Naz712/fleet_adapter_template/3d_models/changi_es1_rescue_stairs/README.md

# Changi AES "ES1" rescue stairs – 3D print model

This folder has 3D-print models of the rescue stairs on Changi Airport Emergency Service's
Rosenbauer E8000-type stair truck. They cover the staircase only, without the vehicle, at three
platform heights. The models are 1:100 scale and come with a display stand, so each one stands
on its own.

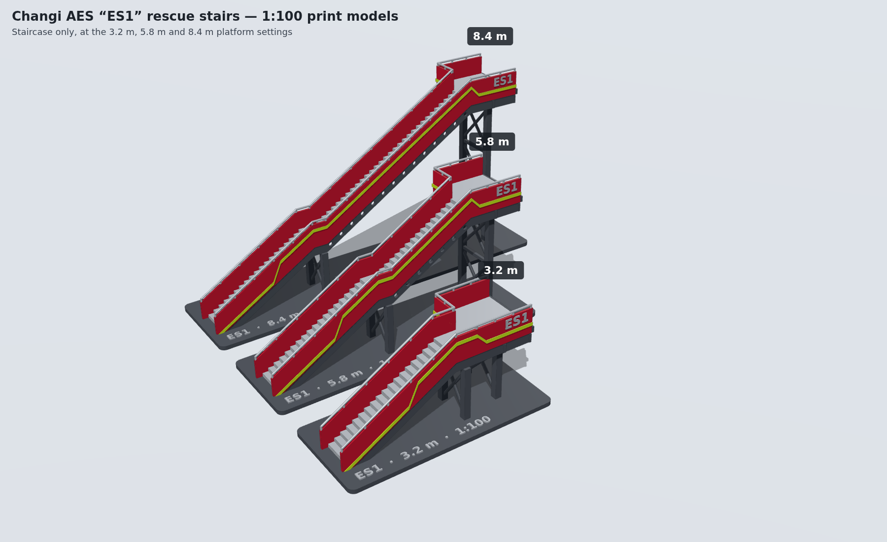
[picture p1: 3d_models/changi_es1_rescue_stairs/preview/lineup_3.2m_5.8m_8.4m.png]
Line-up


## Design

| Item | Value | Source |
|---|---|---|
| Stair width (clear, between side panels) | 1500 mm | brief (matches Rosenbauer spec) |
| Step height | 170 mm | brief |
| Bottom flight | 18 treads / 19 risers, landing at 3230 mm | brief |
| Mid platform length | 1000 mm | brief |
| Tread depth (going) | 280 mm, about 31° pitch | assumed from photos |
| Top platform | 2800 × 3000 mm, flush with the right-hand side and extending left | Rosenbauer E8000 data, photos |
| Guard panel / handrail | 900 mm / 1050 mm above the pitch line | assumed |

The steps stay close to 170 mm at every setting, so only the upper flight changes:

| Model | Top platform | Upper flight | Size at 1:100 (L × W × H) |
|---|---|---|---|
| 3.2 m | 3.23 m (19 × 170) | none: the mid platform runs straight onto the top platform | 98 × 45 × 45 mm |
| 5.8 m | 5.80 m | 15 risers × 171.3 mm | 138 × 45 × 71 mm |
| 8.4 m | 8.40 m | 30 risers × 172.3 mm | 180 × 45 × 97 mm |

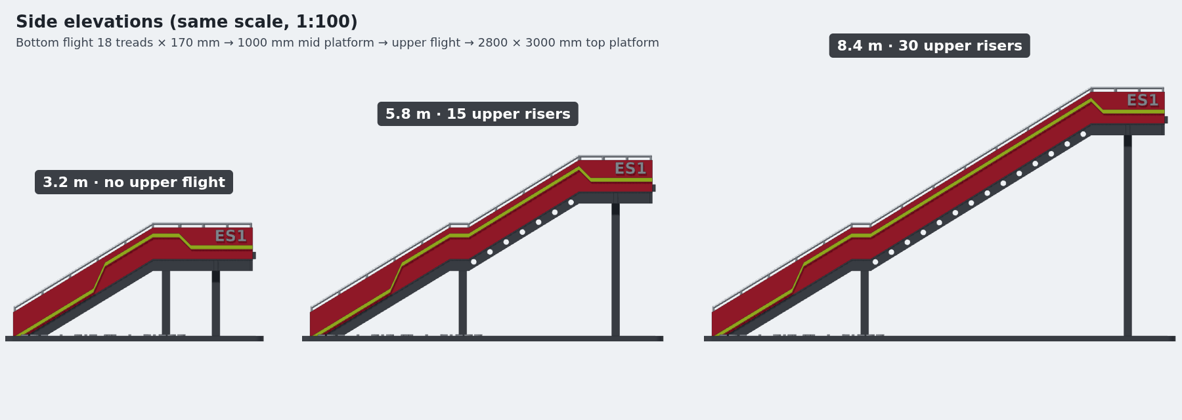
[picture p2: 3d_models/changi_es1_rescue_stairs/preview/side_elevations_same_scale.png]
Side elevations


## Files

- `stl/ES1_stairs_<h>_1-100.stl`: the main print. One solid body with the display stand and a
  name plate on the base.
- `stl/stair_only/…_stair_only.stl`: the staircase with no stand, for mounting on your own base
  or vehicle.
- `stl/multicolour/<model>/…_{red,silver,grey,lime}.stl`: the same model split into colour
  bodies for multi-material printers such as Bambu AMS or Prusa MMU. Load all four files at
  once as a single object with multiple parts, then assign a filament to each part.
- `stl/models.json`: step counts and dimensions for every file.
- `generate_stairs.py`: the parametric generator.

Every STL is checked to be watertight (manifold) and a single connected body.

## Printing tips

- **FDM:** print upright on the base with a 0.4 mm nozzle and 0.12–0.16 mm layers. Turn on tree
  supports and allow them to start on the model, not only on the build plate. The underside of
  the flights and the platforms needs support, but the treads, panels and towers don't.
- **Resin:** tilt the model about 30° and put supports on the underside.
- The livery (lime stripes and "ES1") is raised by 0.4 mm, so it also serves as a painting guide
  on a single-colour print.
- **Other scales:** scaling in the slicer is fine for going bigger. For example, 200% gives 1:50,
  but the 8.4 m model is then about 360 mm long. For a smaller scale, regenerate the files so the
  thin parts stay printable:

```bash
pip install manifold3d trimesh numpy matplotlib
python3 generate_stairs.py --scale 87 --heights 3200 5800 8400
```

Every design value, such as tread depth, platform size, livery or the label, is in the
`Design` dataclass at the top of the script.

## Two-track stair climber simulation

`track_sim/` checks whether a tracked casualty carrier can cross the ES1 stairs, including the
flat mid platform, when it is split into a front and a rear track unit joined by a driven
hinge. It carries a person in a reclining stretcher-chair on a driven levelling pivot, and
compares that vehicle with the same vehicle built as one long straight track.

Open `track_sim/index.html` in a browser, keeping `track-model.js` in the same folder. The page
animates the trip up or down at each height setting, plots the casualty's tilt and the hinge
bend, and recalculates everything when you change the seat or the vehicle, including layouts
with one or both halves of the tracks split in two. `track-model.js` also runs in Node:

```bash
node -e "const TM = require('./track_sim/track-model.js'); console.log(TM.simulate({ height: 8.4 }).summary.two)"
```

### Default design

- **Vehicle:** 0.70 m units (sprocket centre to sprocket centre), a 90 mm sprocket radius, and
  25 kg per unit. The hinge bends ±55° at up to 120° per metre of travel.
- **Seat:** a 120 kg person reclined 45° from vertical, in a stretcher-chair that weighs 25 kg
  with its drives. It sits on an arm 0.5 m above the hinge axle, so every posture from sitting up
  to lying flat fits. The seat's load centre is set 15 cm towards the head from the arm. The
  person rides head uphill: backwards going up and facing forward coming down.
- **Balance arm:** a drive at the foot of the arm leans it up to ±50° from halfway between the
  units, at 60° per metre of travel. It keeps the weight away from whichever edge the vehicle is
  near. Drives on top of the arm keep the seat level.

### Results

Worst case over the three height settings.

| | Two tracks + driven hinge | One long track |
|---|---|---|
| Casualty tilt, worst moment | 5° (the seat drives catch up within 3 cm) | 25° |
| Vehicle pitch change per 10 cm of travel | 7.9° up, 8.6° down | 31.6° |
| Worst drop at a platform edge | none, up or down | 23 cm (tips over the edge) |
| Lean it can take anywhere before it falls | 10.7° up, 8.3° down | falls at every edge |
| Hinge bend used | ±40° | – |

"Lean it can take" is how far a push, a hard stop or a bump can lean the weight before the
vehicle falls over an edge. A stop from walking pace (0.25 m/s) in 0.2 s leans it 7.3°.

The fit of the seat and person depends on the recline. With the default 0.5 m arm, the closest
gaps to the steps and to the vehicle's own tracks are:

| Recline | Posture | To the steps | To its own tracks |
|---|---|---|---|
| 15° | sitting up | 25 cm | 6 cm |
| 30° | leaning back | 34 cm | 15 cm |
| 45° | half lying, half sitting | 45 cm | 25 cm |
| 60° | half lying | 45 cm | 28 cm |
| 75° | mostly lying | 26 cm | 21 cm |
| 90° | lying flat | 11 cm | 2 cm (tight) |

### How the seat is held up

A level stretcher over a 31.6° flight has stairs about 0.6 m higher under one end of each metre
than the other, and the slope reverses at every platform. Legs on each track unit would have to
grow and shrink by that much all the time, so the support sits in the middle, on the hinge axle.
Operating tables hold lying patients the same way, on one central column with a tilting top.
The support is built to look and be sturdy:

1. **Two track units**, front and rear, each with a left and a right rubber track, 0.75 m across.
   The tracks have cleats that hook the step nosings.
2. **Hinge axle and hinge motor.** A 40 mm steel axle joins the units. A self-locking gear motor
   bends the hinge and holds a fold with the power off, about 580 N·m (1.2 kN·m with bumps). It
   must turn at least 90° per metre of travel (23°/s at walking pace).
3. **Averaging link.** A 150 mm arm fixed to each unit, and two equal links to a collar on a short
   post. The four equal sides make a diamond, so that post always points halfway between the two
   units. The arm leans from it, and it passes the arm's load equally into both units.
4. **Arm drive.** A self-locking gear motor at the foot of the arm leans it up to ±50° from halfway
   at 15°/s. It holds up to 500 N·m (1 kN·m with bumps).
5. **Arm.** Two 50 × 50 × 4 mm steel box columns 0.4 m apart, joined by cross tubes, 0.5 m from
   the hinge axle to the seat's tilt axle. The two columns stop it rocking sideways.
6. **Tilt drives and cradle.** Two self-locking tilt drives on top of the columns keep the seat
   level; either one can hold the seat alone. A cradle of two 40 × 40 × 3 mm rails and struts
   holds the seat on a triangle, not on a single point.
7. **Stretcher-chair.** Reclines from 15° (sitting up) to 90° (flat), with a four-point harness
   and a foot stop so the person can't slide more than about 10 cm.

Side to side, the centre of mass is 0.71 m off the ground, so a 0.75 m wide vehicle only tips
past 28° of side tilt. The stairs have no side slope, so that margin covers the person shifting
and bumps.

### Stress test

`stress-test.js` puts the default design through harder conditions at all three height settings,
in both directions, and sizes the support parts at twice the worst load:

```bash
cd track_sim && node stress-test.js
```

It also writes `stress-results.js`, which the page shows. A case passes if the vehicle never
falls and can take a 7.3° lean anywhere. It runs four ways of holding up the seat, and the three
layouts with one or both halves of the tracks split in two (see below):

| Seat support | Pass | Tight | Fail | Lean it can take, default (up · down) | Seat drives, with bumps |
|---|---|---|---|---|---|
| One balancing arm (recommended) | 17 | 4 | 3 | 10.7° · 8.3° | arm drive 1.0 kN·m, two tilt drives 0.48 kN·m |
| Two arms from the hinge (a V) | 12 | 6 | 3 | 9.5° · 7.8° | two arm drives 0.82 kN·m |
| Two arms, one on each track | 7 | 7 | 7 | 16.1° · 9.9° | two arm drives 0.89 kN·m |
| One arm without a drive | 7 | 9 | 5 | 8.0° · 8.2° | two tilt drives 0.48 kN·m |

One case is not a stress but a possible fix: a hinge motor half as fast again (180°/m). With the
balancing arm it passes, taking 13.1° up and 7.8° down.

Two arms holding the stretcher like a bed look the most reassuring, but only if they rise from
the hinge. Standing on the track units, the arms' feet swing at every fold and, on the flights,
one sits about 25 cm lower than the other. The arms have to keep correcting: on steeper stairs
the cradle tilts up to 16°, lying flat hits the steps, and the vehicle needs a faster, wider
hinge. Rising from the hinge, the two arms keep most of the single arm's stability. They lose
margin only with a 200 kg person, a person who has slid 25 cm, or a smaller hinge.

The single balancing arm passes the most cases. Its results case by case:

- **Passes:**
  - a 200 kg or a 40 kg person;
  - a person sliding 10 cm either way, or 25 cm towards the feet;
  - sitting up, or lying flat and sliding;
  - stairs as steep as 35.8°;
  - a hinge at three-quarter speed or with only ±45° of range, or one half as fast again;
  - a seat drive at half speed;
  - an arm drive that seizes in the middle or leaning uphill;
  - a seat drive stuck level, with the arm taking over the levelling.
- **Tight:**
  - lying flat comes within 2 cm of the front track;
  - an arm drive seized leaning 20° downhill;
  - a seat drive stuck on a flight;
  - a 200 kg person half lying on 35.8° stairs.

  None of these falls, but a hard stop at the worst moment could rock the vehicle.
- **Fails:**
  - a hinge motor at half speed drops 17 cm at an edge;
  - a hinge motor that seizes and keeps driving becomes one long track and drops 23 cm;
  - a 200 kg person lying flat on 35.8° stairs hits the tracks.

Without its drive, the arm only passes the default case with 8.0°. It fails with the person
sliding 25 cm, and is tight on steeper stairs and with a ±45° hinge. That is why the balance arm
is part of the design.

The support parts stay 6 to 100 times below their limit at twice the worst load for a 120 kg
person, and at least 3.7 times below for 200 kg. What the stress test asks for:

1. Keep the balance arm.
2. Use a hinge motor that turns at least 90° per metre of travel.
3. Stop the tracks the moment the hinge stops following.
4. After any drive fault, stop gently over half a second. That leans the weight only 2.9°,
   which every tight case can take.
5. Fit a four-point harness and a foot stop.
6. Make the arm about 5 cm taller if people will be carried lying flat on steeper stairs.
7. Use cleated tracks. Holding on the flight needs a grip (friction coefficient) of 0.61, and a
   hard stop going down 0.76. Wet rubber on steel can be well below that.

### Splitting the halves in two

The model also handles more than two sections (`sections` and `mainJoint` in `track-model.js`,
and "Track layout" on the page). The seat stays on the middle hinge. One or both halves are split
into two 0.35 m sections, joined by a hinge with its own motor, about 6 kg. The rules are the same
as for two sections, section by section. With two 0.70 m sections, the model gives exactly the same poses
as the two-section one, which is how it was checked.

Each extra hinge bends at an edge to keep its half's tracks on the stairs. While its half goes
last (going down for the front half, going up for the rear half), its end section stays flat on
the step behind while the section next to the seat follows the new slope. The trailing end keeps
holding the vehicle up just when a straight unit would lift off and leave it balancing on the
edge; most of the gain comes from this. While its half goes first, the half is held in line, but
once the extra hinge is past an edge it lets the end section down onto the next step, so the
tracks touch the stairs while the seat's hinge is still folding the half down. A short section
has to turn twice as fast for the same change of slope, so the extra hinge turns at up to 240° per
metre, twice the seat's hinge.

Worst case over the three height settings, with the balancing arm:

| | No split | Front half split | Rear half split | Both halves split |
|---|---|---|---|---|
| Lean it can take (up · down) | 10.7° · 8.3° | 11.2° · 18.7° | 17.9° · 9.5° | 18.8° · 21.5° |
| Stress test (pass · tight · fail) | 17 · 4 · 3 of 24 | 20 · 3 · 3 of 26 | 22 · 0 · 4 of 26 | 23 · 1 · 2 of 26 |
| Extra hinge motors, mass with the casualty | 0, 195 kg | 1, 201 kg | 1, 201 kg | 2, 207 kg |
| Extra hinge at 120°/m (up · down) | – | 11.2° · 9.3° | 13.3° · 9.4° | 13.7° · 12.3° |
| Extra hinges seized straight (up · down) | – | 10.3° · 7.7° | 10.0° · 10.0° | 9.9° · 8.8° |

- Splitting both halves is best both ways: 18.8° up and 21.5° down, and 23 of 26 stress cases.
  It is the only layout that still passes with the seat's hinge motor at half speed, because the
  leading half's end section reaches the stairs while the seat's hinge is still folding. If the
  seat's hinge seizes, it drops 12 cm, against 18 to 23 cm for the other layouts.
- The front split more than doubles the lean the vehicle can take going down, which is where no
  split is weakest. Going up it takes 0.5° more than no split.
- The rear split gains going up. Going down it gains only 1.2°, because its front half, which
  goes last going down, is not split. Lying flat, its backrest comes 4 mm into the front track
  unit, which fails that case.
- The failures left: the seat's hinge seizing (a 12 to 21 cm drop), and a 200 kg person lying flat
  on 35.8° stairs, whose backrest hits the steps. The front and rear splits also still fail with
  the seat's hinge motor at half speed.
- If the extra hinges seize straight, the vehicle becomes the one with no split, which passes.
- A 0.35 m section spans only one gap between nosings, so on a flight its hinge must hold it in
  line.
- How the leading half bends matters. Letting its end section down about its own hinge, lifting
  nothing, is what gains; folding the end section first by lifting the section inside it lifts
  that section off the edge nosing, and both halves split then takes only 11.9° going down.

`track_sim/compare.html` runs all four layouts side by side on the same stairs, plots the lean
each can take along the trip, and puts every stress case next to each other.
`node track_sim/compare-test.js` regenerates its per-height numbers (`compare-results.js`).

### Building a model

`track_sim/blueprint.html` is a build sheet for a model of the layout with both halves split,
made from parts sold in Singapore. Pick the GT2 pulley and closed belt loop you buy, and it redraws
the side view, the top view, the centre box space, the tread, the seat's hinge and the wiring to
scale, and sizes the test stairs to match. 20-tooth pulleys with 110 mm loops, both stocked in Singapore, put the axles 35 mm apart,
which is exactly 1:10. Its parts list (`blueprint-parts.js`) links each part to a shop. It also runs
the simulator on the test stairs (the `lowerTreads` option in `track-model.js` gives one flight) and
lists the hinge, arm and seat angles every 5 mm of travel, to replay from the drive motor's encoder.

### Bending test: no bending, 2 parts, 4 parts

`track_sim/bending.html` carries the casualty up and down the ES1 stairs as measured (8.4 m in two
flights of 175 × 250 mm steps, 35°, a 1 m mid-landing, a 3 m top platform) four ways, in step:
one stiff track, two track units, four sections, and a stiff track with front arms. It uses the team's levelling design: no seat
arm, the 3-part platform hinged on top of the centre box (`mastMode: 'base'`, 0.32 m above the
track axles) and kept level by a linear actuator. The box (400 × 400 × 220 mm, 15 kg) is bolted to
the section behind the middle hinge, and every pose checks its gap to the steps and to the platform.
The tracks are modelled on parts MISUMI stocks in Singapore: HTD 8M timing belts, 40 mm wide, on
60-tooth pulleys (85 mm from axle to grip, 15 mm cleats every 56 mm). 1200 mm belts give 0.36 m
sections and 1880 mm belts the 0.70 m units; the prototype uses HTD 5M belts on 20-tooth pulleys.

A hinge only pushes its track down onto the stairs (`reach: 'lie'`): to put a track end down it may
lift the vehicle off them by 5 cm at most (`maxLift`). It never stands the vehicle on its two ends
with the middle in the air. That would need a hinge motor strong enough to hold the vehicle and
casualty off the ground, with only the end tracks gripping. (The model's default, `reach: 'lift'`,
still allows it, for the older pages.)

It compares two ways of bending. **Stop, bend, then go** (`bendMode: 'stopGo'`, the page's
default): the vehicle drives at 0.25 m/s and stops wherever a hinge or the levelling has to turn
further than it can on the move (the middle hinge 30° a second, the end hinges 58°, the levelling
37.5°). A hinge only turns as far as still leaves 25° of lean before tipping (`stopGoSafeDeg`);
otherwise it holds its bend until more track is on the stairs. A laser at the leading end of the
track looks straight down (`laserRisers`): near a platform edge the hinges stay locked until it
reads 1¼ risers (219 mm) further than on flat ground, then the vehicle stops and bends. **Bend while
moving** (`bendMode: 'moving'`): the hinges turn as it drives, the middle one up to 120° per metre.

The front arms follow the Cal Poly Pomona "Wheelchair Stair Climber" on GrabCAD (`stair-climber-1`,
a 605 × 420 mm prototype): a stiff main track with a pair of track arms on its front axle that swing
up to climb a step and down to reach over an edge. Scaled up, a 0.80 m main track carries the box and
platform at its middle and 0.72 m arms swing down by up to 90° or up by up to 45°, where the platform
gets in the way (`reach: 'touch'`, `armUpDeg`). The main track rests on the stairs by its own weight
and the arms swing until they just touch the stairs ahead, so they catch the vehicle at an edge but
never hold it up. It turns round at the top so the arms lead both ways (`dirs` runs each way as its
own layout). The split matters: with the prototype's proportions (0.92 m and 0.60 m) it keeps only
7–10° at the top edge, while any main track from 0.66 to 0.83 m (arms making up 1.52 m) keeps about
25° going down and 11–15° going up.

| Layout | Least lean before tipping, down · up: stop, bend, then go | Bending while moving | Trip down · up, stop, bend, then go (of it stopped) |
|---|---|---|---|
| No bending (1.40 m) | tips · tips (drops up to 33 cm) | the same | 74 s · 74 s |
| 2 parts (2 × 0.70 m) | 14.5° · 17.5° | tips (drops up to 29 cm) | 79 s (5 s) · 79 s (5 s) |
| 4 parts (4 × 0.36 m) | 24.4° · 24.4° | tips (drops up to 8 cm) | 89 s (15 s) · 83 s (10 s) |
| Front arms (0.80 m + 0.72 m arms) | 25.9° · 14.0° | 8.7° · 8.0° | 80 s (6 s) · 81 s (8 s) |

Stopping to bend is what keeps the hinged tracks up: bending while moving, the hinges can't fold a
track end down in time at an edge without lifting the vehicle. The front arms are the exception:
they only have to touch the stairs, so they stay up bending while moving too. The 4-part track keeps the most lean.
The 2-part track stays up, but its long halves overhang an edge until the middle hinge gets there.
The track that can't bend tips at the edges either way: it has no hinge to bend. The casualty stays
within 1° of level on the bending tracks.

Where the laser stops it matters. On the flights the steps alone make it read up to 1.1 risers
further than on flat ground, so it must stop above that; any later and more of the track is past
the edge before it bends:

| Laser stops it at | 2 parts, down · up | 4 parts, down · up | Front arms, down · up | |
|---|---|---|---|---|
| 1 riser (175 mm) | 15° · 18° | 24° · 24° | 26° · 14° | would also stop on every step of the flights |
| 1¼ risers (219 mm) | 15° · 18° | 24° · 24° | 26° · 14° | best: the same as stopping in exactly the right spot |
| 1½ risers (263 mm) | 11° · 18° | 10° · 24° | 19° · 14° | late going down at the mid-landing |
| 2 risers (350 mm) | 11° · 18° | 10° · 22° | 19° · 14° | late at the mid-landing; the 4-part platform brushes its tracks |
| 3 risers (525 mm) | 11° · tips | 10° · tips | 19° · 14° | 2 and 4 parts tip going up at the mid-landing edge and the top edge (drops up to 26 cm), and going down their platforms knock their own tracks |

The 2-part units are 0.70 m from axle to axle. Stopping to bend, that is as steady as 0.76 m
(15° going down, 18° going up), 12 cm shorter overall (1.57 m), and it takes a stock 1880 mm HTD 8M
belt (235 teeth). At 0.69 m one end rocks down 5 cm at an edge going down, leaving 8.5°, and its belt
would need 232½ teeth. Bending while moving, every length tips at an edge. At 1:5 the units are
140 mm on 380 mm HTD 5M belts (76 teeth). The page also lists the tallest box
for each length, the stricter of the two ways of bending (4 parts: 300 mm long at 250 mm tall, or
400 mm at 244 mm; 2 parts: 500 mm at 250 mm; front arms: 400 mm at 250 mm; no bending: 600 mm at
250 mm). The 400 × 400 × 220 mm box fits all four.

### How the 2-part vehicle is built

The page's "How it is built" section draws the 2-part vehicle with 0.70 m units at full size: a top
view with the platform removed, and a side view of the hinge. Its "Track parts and dimensions"
section lists the sizes, full size and 1:5.

- **Two units on one axle.** The rear and front units both turn on the middle axle, on bearings in
  their side plates: the rear unit's plates inside, the front unit's just outside them. Each unit has
  one 40 mm belt per side. The rear unit's belts run in the outer lane and the front unit's in the
  inner lane, so both fit on the middle axle. Overall 1570 × 700 mm (1600 mm over the cleats),
  170 mm tall (200 mm with cleats), 400 mm between the side plates.
- **Hinge.** A worm gear motor in the box turns a cross shaft with a small gear at each end. Each
  gear meshes with a toothed sector on one of the front unit's side plates, so the two units swing
  up to 55° either way about the middle axle, at 30° a second. These stairs need 35° up at the foot
  of a flight and 39° down over an edge. The bend is the angle between the units, so either one can
  tip: going down, the rear unit leads and tips over the edge, carrying the box. A worm resists being
  back-driven, but vibration can make it creep, so the motor also has a spring-applied brake to
  hold the bend with the power off. At 1:5 the gears are bigger than scale (module 1.25, 32 : 14
  teeth, about 2.3:1), so they can be printed and a 270° servo covers the whole ±55°.
- **Drive.** The drive motor in the box turns the middle axle through a chain. Both units' pulleys are
  clamped to it, and bending about it doesn't stretch or slacken the belts, so both tracks drive at
  any bend. The end axles turn freely.
- **Box and platform.** The 400 × 400 × 220 mm box holds the battery, the drive motor and the hinge
  motor. It sits between the rear unit's side plates, from 280 mm behind to 120 mm in front of the
  middle axle. The platform pivots on two pillow blocks on top of it, 320 mm above the middle axle.
  The platform and its levelling are designed separately.
- **Lasers.** One at each end, 45 mm beyond the end axle, looking straight down between the tracks.
- **Axles.** 35 mm steel bar (C45) at full size in UCFL207 flange bearings; 8 mm rod in KFL08s at
  1:5. The worst case is a step edge under the end of a unit while the belts pull hard: about 1.7 kN
  on each pulley. The rear unit's belts run in the outer lane, 108 mm outside its bearings, so they
  bend its axles with about 180 N·m, and the middle axle also carries up to about 65 N·m of drive
  torque each side and the chain's pull. A 35 mm axle takes that with a safety factor of about 3 and
  bends so little that the outer pulleys tilt under 0.25°, the limit for timing belts. A 30 mm axle
  would tilt them 0.34°, and the belts would walk off; 40 mm only adds about 8 kg with its bigger
  bearings. At 1:5 the 8 mm rod is about four times stronger than it needs to be.
- **Slide strips.** A low-friction plastic strip under each belt's lower run, between its pulleys,
  carries the load where a step edge presses on the belt. Without it the belt bows up between the
  pulleys, by several centimetres at full size, and the tracks don't stay straight on the stairs as
  the simulation assumes.

The page also lists the parts for the tracks and hinge of one vehicle, with rough prices in Singapore
dollars (October 2026): about S$240 for the 1:5 prototype and about S$2,900 at full size. The motors,
battery, lasers and controller, and the platform with its levelling, come from the rest of the team.
RS Singapore prices are as listed; the rest come from online listings, and the full-size gears and
plates are estimates. Check stock and prices before ordering.

A second top view draws the 4-part version for comparison: four 360 mm sections on five axles, with
the same box, platform and lasers. Its middle hinge works as above; each end hinge has its own motor
on the end section, turning a toothed sector on the next section. It needs 8 shorter belts (1200 mm),
16 pulleys, 5 axles, 16 bearings, 8 slide strips and three sets of hinge gears: about S$460 at 1:5
and S$5,700 at full size.

### Printable track for the 1:5 prototype

`track_print/` has a 3D-print file for the prototype's tracks, sized to the team's 1:5 base:
two segments 225 mm axle to axle, each with a 550 mm track loop on wheels about 1.5 cm in
radius. The track is a one-piece TPU loop printed as a ring, with 110 HTD 5M teeth inside so it
runs on bought HTD 5M 20-tooth pulleys. Its 45 cleats are 12.22 mm apart, a fifth of the 1:5 ES1
edge-to-edge distance (35 × 50 mm steps, 61.03 mm along the slope), so every step edge under a
segment sits in a gap between cleats and the cleat above it stands on the tread. In the
simulator, 1.125 m segments (22.5 cm at 1:5) stop, bend and go as well as 0.70 m ones: 14.5° of
lean before tipping going down and 18° going up. See `track_print/README.md` for printing,
buying and assembly.

### Centre box, tracks and tread

The battery and drive motor go in a box between the tracks, bolted to the section just behind the
seat's hinge (T2). Bolting it to one section needs no extra linkage, and it is nearly as big as a box
held halfway between the two middle sections (93% of the side area). The space was found by
running every pose of the four-section chain (3.2, 5.8 and 8.4 m flights and the steepest stairs,
both ways) in that section's frame. Blueprint sheet C draws it.

| Centre box | Full size | 1:10 model |
|---|---|---|
| Length | 500 mm: 290 behind the seat's hinge axle, 210 in front | 50 mm: 29 behind, 21 in front |
| Height | 250 mm: floor 40 and top 290 above the axle | 25 mm: floor 4, top 29 |
| Width | up to 300 mm, inside the seat arm's two columns | 38 mm, between T2's side plates |
| Limits | the next section's axle (70 mm clear), the stairs below, the seat above | the same, 7 mm clear |

Only the hinge axle passes under the box; a gear on it reaches up through a slot to the motor. At
1:10 the seat's hinge servo (S2) and the arm servo (S4) also sit in it, with the motor and a small
battery. Weight in the box steadies the vehicle a little: with 40 kg the worst lean it can take is
19.8° going up and 21.7° going down (18.8° and 21.5° without). `boxMass` in `track-model.js` tries
other weights.

Each section's track is a loop around two axles 350 mm apart (35 mm at 1:10), 150 mm wide per side
in two lanes, and 180 mm high (Ø180 sprockets). Neighbouring sections run in alternate lanes so
they share an axle. Pulleys are clamped to the axles and the section frames turn on bearings: the
motor turns the seat's hinge axle, which drives the middle two sections, which turn the next axles
and the end sections. One motor drives every track at the same speed. A full-size vehicle that
steers splits each axle into left and right halves, with one motor per side.

The tread is soft rubber (about 60 Shore A) with straight cleats across it: 15 mm tall, 20 mm wide
at the root and 10 mm at the tip, every 60 mm, offset by half a pitch between the two lanes. On
stairs the tracks only touch the step edges. A cleat just behind an edge drops onto the tread
within 1.9 times its height of the edge and catches there, so the tracks can't slide down even on
dusty or wet steps. Without cleats the rubber needs a friction of at least 0.62 to hold on these
stairs. Taller or sharper cleats jolt over each edge and wear the nosings.

### Design rules from the math

1. Each unit must always bridge two step nosings. Nosings are 328 mm apart, so a unit needs at
   least 657 mm.
2. One unit (0.88 m overall) must fit on the 1.0 m mid platform. The whole vehicle is longer than
   the platform, so it crosses in an S-bend.
3. The hinge needs a range of at least ±45°, even though the slope only changes by 31.6°. It has
   to fold the leading unit down before the middle reaches the edge.
4. The hinge must be driven, at 90–150° per metre of travel. Slower, the fold comes too late and
   the vehicle drops at an edge. Much faster, it over-reacts. With a free hinge, the units follow
   gravity and the front rears up on the risers.
5. The hinge holds its fold over an edge until the centre of mass is 5 cm past it, so the trailing
   unit keeps its end on the stairs.
6. The vehicle must be able to take a hard stop anywhere, a 7.3° lean. The balance arm and the
   seat's offset towards the head give it at least 8.3°.
7. Half lying (a 45–60° recline) is the most compact posture. Sitting up and lying flat both need
   the 0.5 m arm.
8. A split half's hinge bends at each edge to keep the tracks on the stairs, at twice the seat
   hinge's speed. Going last, it keeps the end section on the step behind. Going first, it holds
   the half in line but lets the end section down onto the next step once it is past the edge.

The model is quasi-static (slow speed). At every centimetre it solves how both units rest on the
real step geometry, then checks support, the gap around the seat and person, and tipping. Tracks
ride on the line joining the step nosings. The person is a 1.80 m adult built from standard
body-segment proportions. Forces and torques are for slow, steady driving, with a factor of two
for bumps; impacts and braking dynamics are not modelled.
