Naz712/fleet_adapter_template/3d_models/changi_es1_rescue_stairs/preview/ES1_stairs_5.8m.png

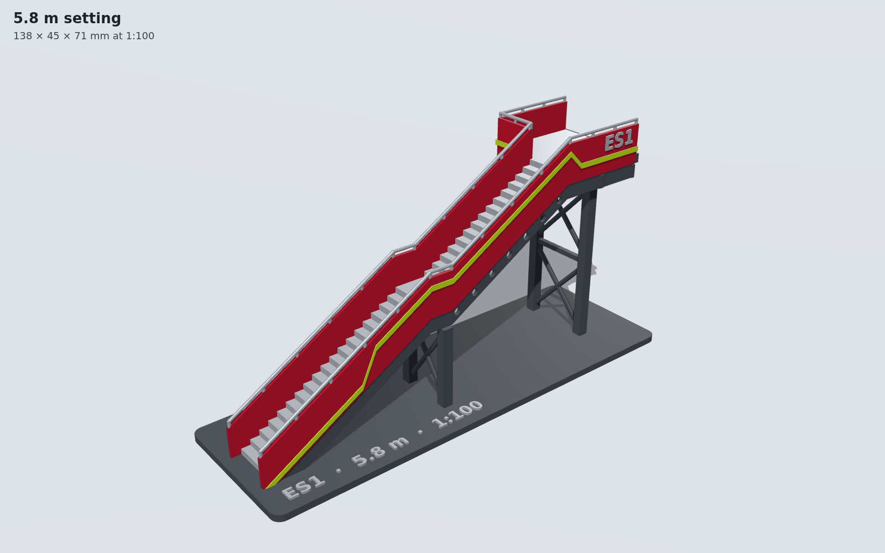
3d_models/changi_es1_rescue_stairs/preview/ES1_stairs_5.8m.png
