Naz712/fleet_adapter_template/3d_models/changi_es1_rescue_stairs/preview/ES1_stairs_8.4m_top_platform.png

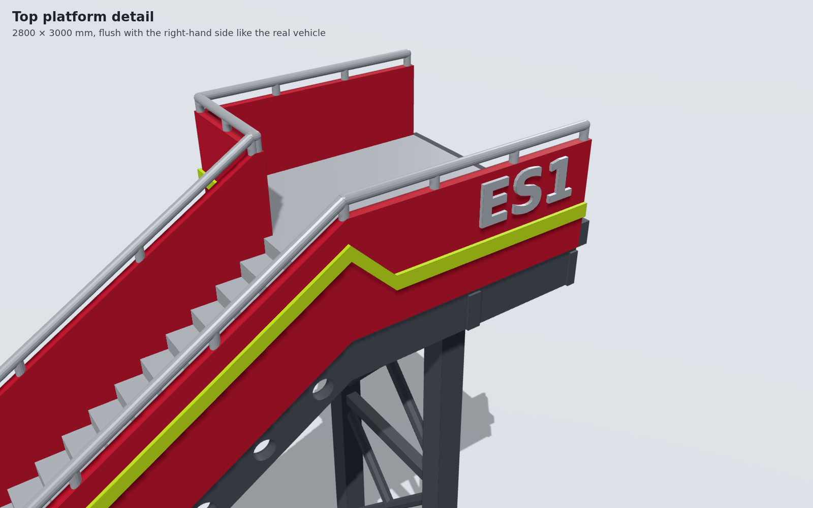
3d_models/changi_es1_rescue_stairs/preview/ES1_stairs_8.4m_top_platform.png
