Naz712/fleet_adapter_template/3d_models/changi_es1_rescue_stairs/slides/slide3-top-view.png

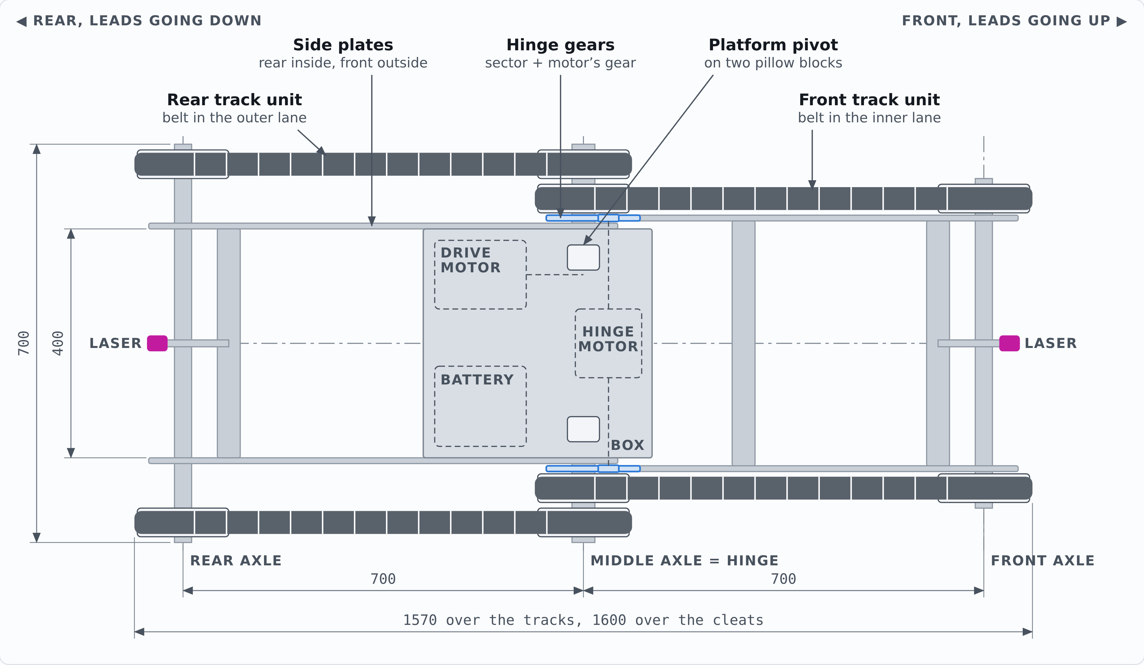
3d_models/changi_es1_rescue_stairs/slides/slide3-top-view.png
