Naz712/fleet_adapter_template/3d_models/changi_es1_rescue_stairs/slides/slide5-stop-bend-go.png

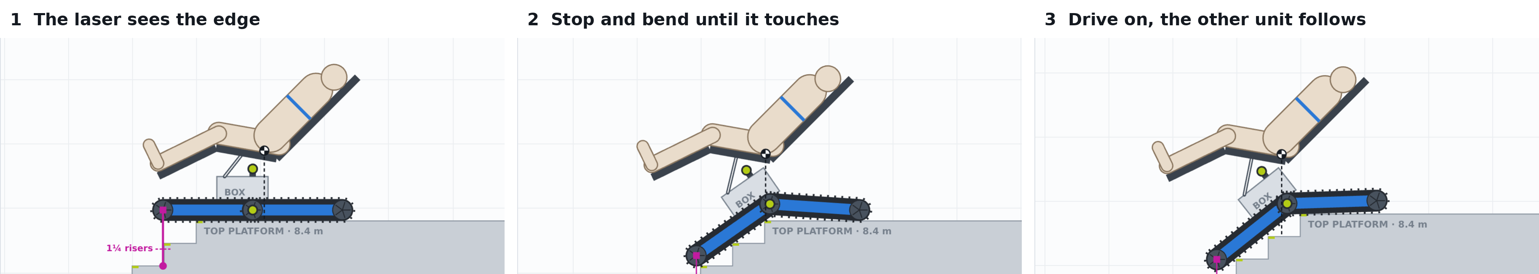
3d_models/changi_es1_rescue_stairs/slides/slide5-stop-bend-go.png
