Naz712/fleet_adapter_template/3d_models/changi_es1_rescue_stairs/slides/track-deck/still-rigid-tip-drawing.png

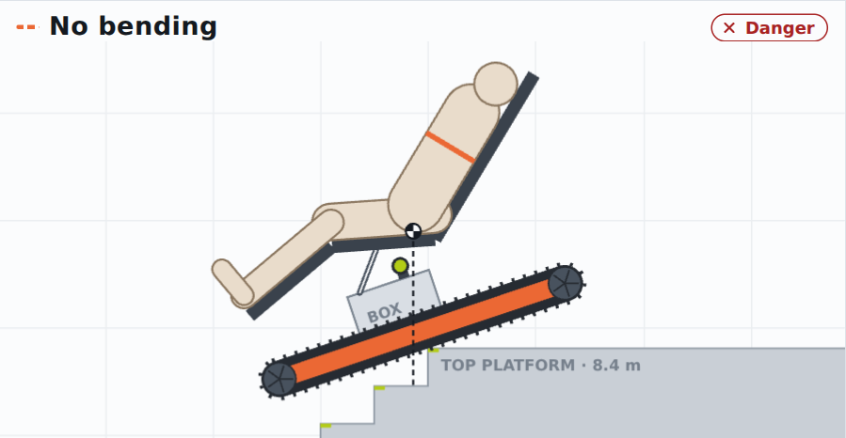
3d_models/changi_es1_rescue_stairs/slides/track-deck/still-rigid-tip-drawing.png
