Naz712/fleet_adapter_template/3d_models/changi_es1_rescue_stairs/slides/track-deck/still-two-bend-1125.png

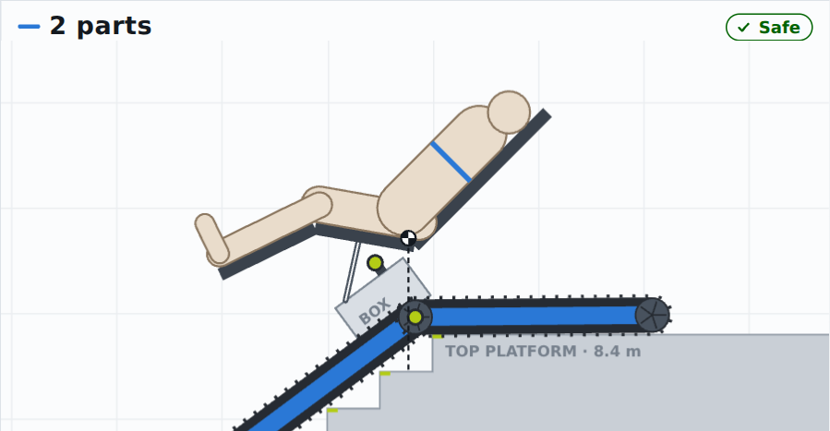
3d_models/changi_es1_rescue_stairs/slides/track-deck/still-two-bend-1125.png
