Naz712/fleet_adapter_template/3d_models/changi_es1_rescue_stairs/slides/track-deck/stop-bend-go-1125.png

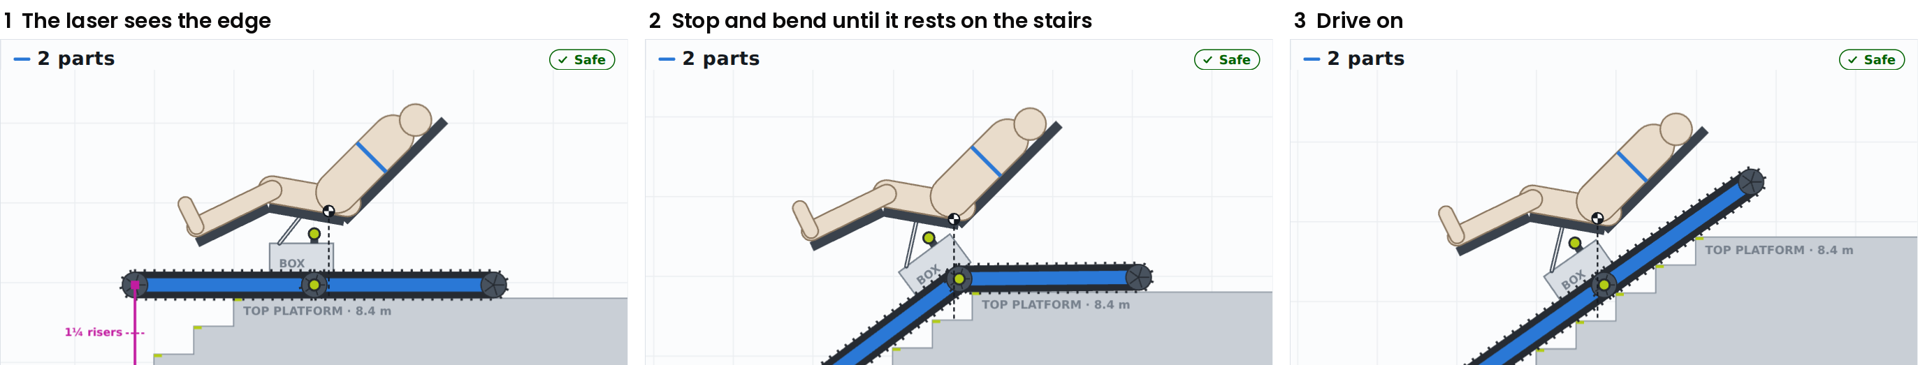
3d_models/changi_es1_rescue_stairs/slides/track-deck/stop-bend-go-1125.png
