Naz712/fleet_adapter_template/3d_models/changi_es1_rescue_stairs/track_print/assembly/printed_parts_pack.pdf

# Exploded view: the parts you print (orange), pulled apart along the axles

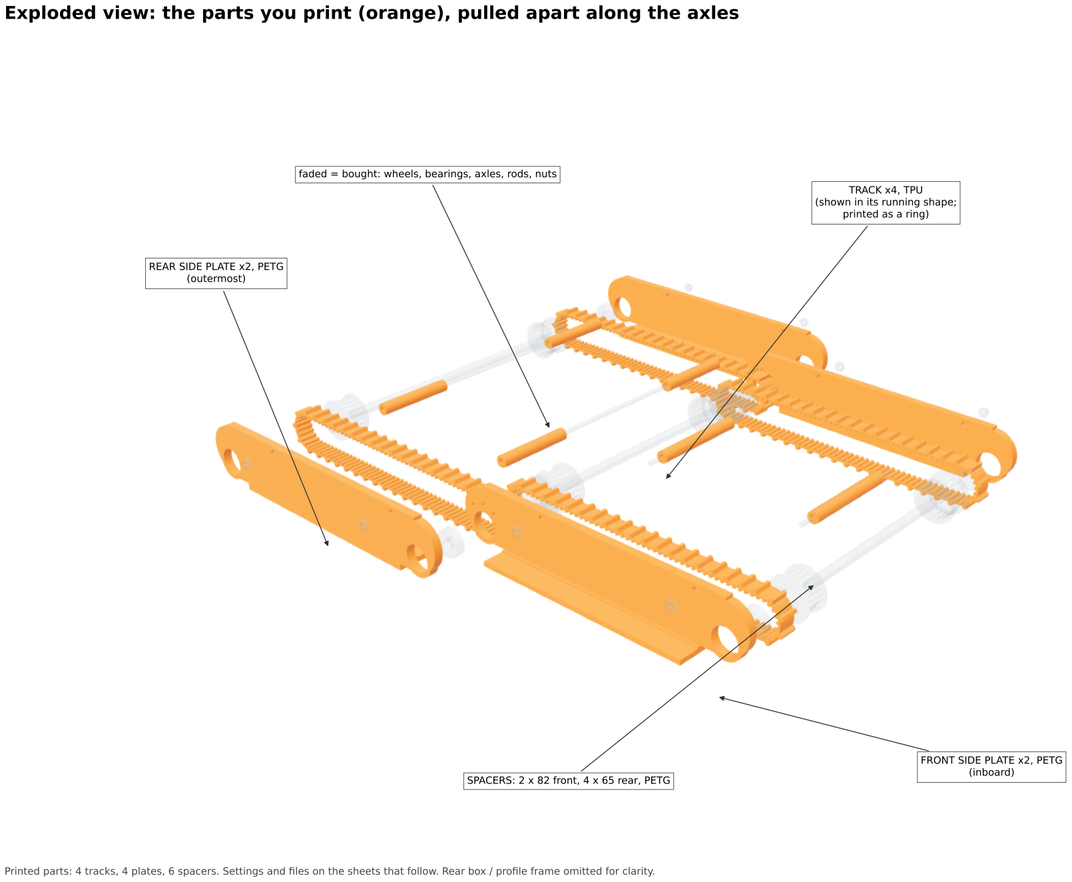
[picture p27: page 1]

TRACK x4, TPU
(shown in its running shape; printed as a ring)

REAR SIDE PLATE x2, PETG
(outermost)

FRONT SIDE PLATE x2, PETG
(inboard)
SPACERS: 2 x 82 front, 4 x 65 rear, PETG faded = bought: wheels, bearings, axles, rods, nuts

Printed parts: 4 tracks, 4 plates, 6 spacers. Settings and files on the sheets that follow. Rear box / profile frame omitted for clarity.

# Exploded view: everything, same spread

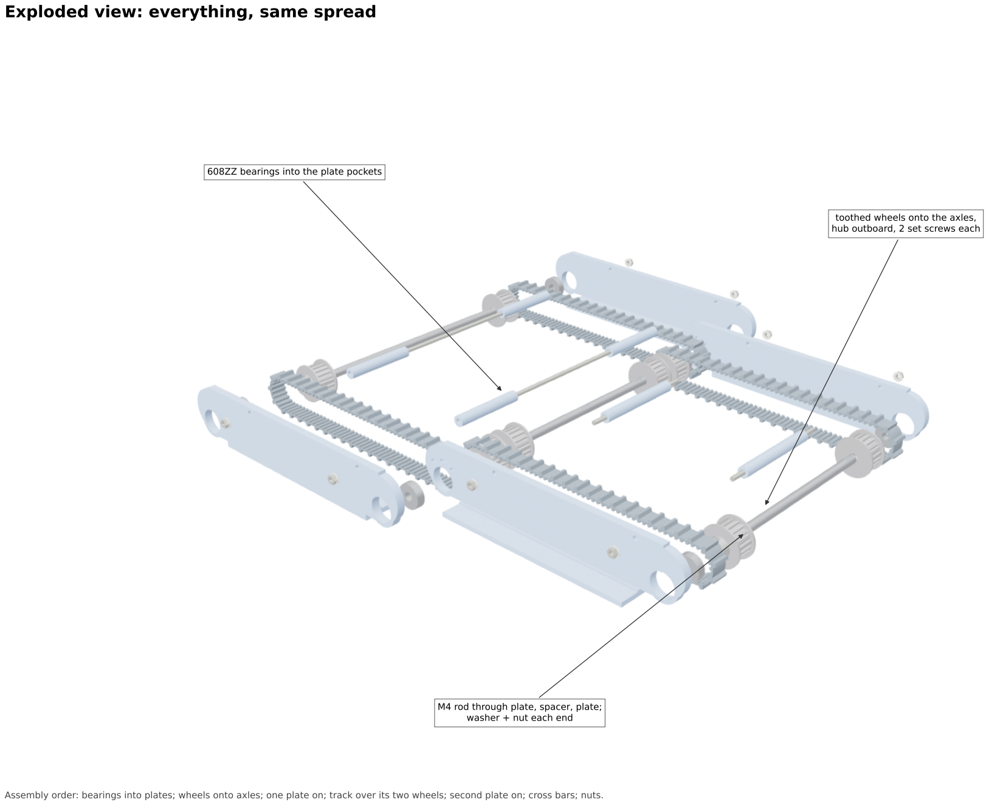
[picture p28: page 2]

608ZZ bearings into the plate pockets

toothed wheels onto the axles, hub outboard, 2 set screws each

M4 rod through plate, spacer, plate; washer + nut each end

Assembly order: bearings into plates; wheels onto axles; one plate on; track over its two wheels; second plate on; cross bars; nuts.
