Naz712/fleet_adapter_template/3d_models/changi_es1_rescue_stairs/stl/multicolour/ES1_stairs_3.2m_1-100/ES1_stairs_3.2m_1-100_silver.stl

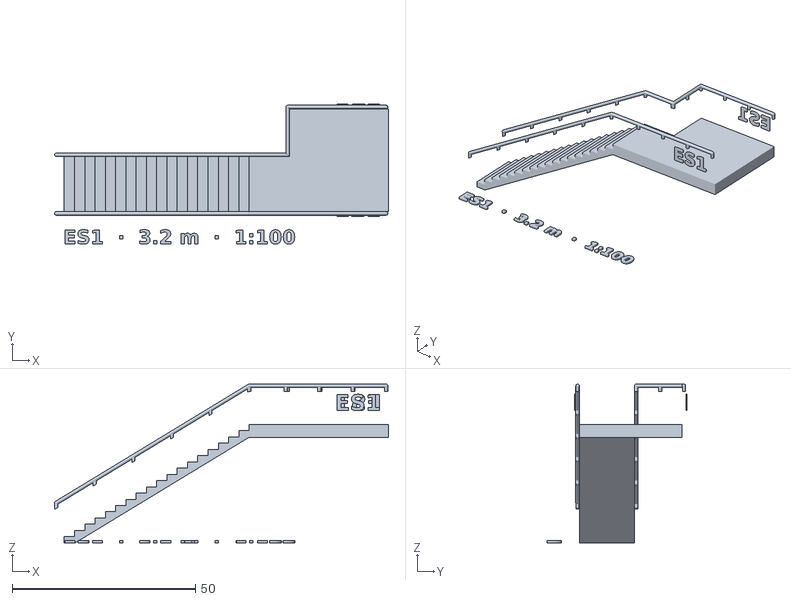
[picture p32: CAD file, 2026-09-26]
3d_models/changi_es1_rescue_stairs/stl/multicolour/ES1_stairs_3.2m_1-100/ES1_stairs_3.2m_1-100_silver.stl
91.1 x 38.3 x 43.3
