Naz712/fleet_adapter_template/3d_models/changi_es1_rescue_stairs/stl/stair_only/ES1_stairs_8.4m_1-100_stair_only.stl

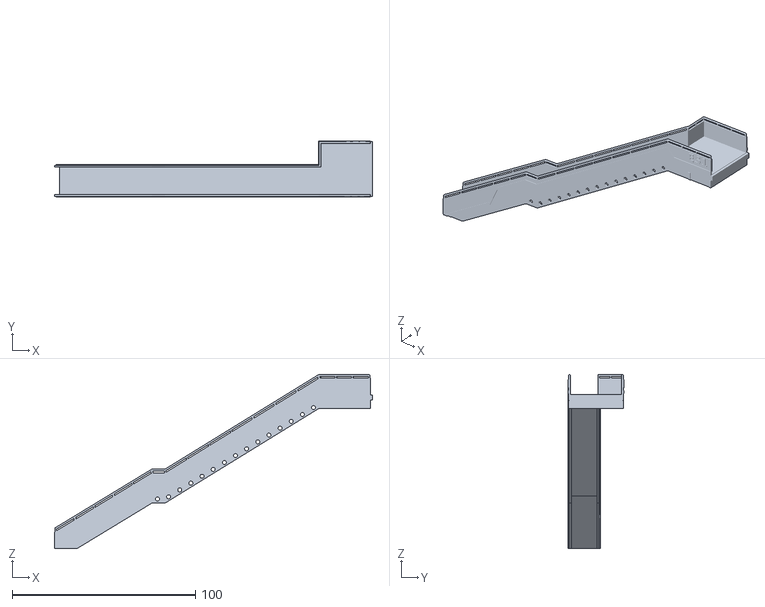
[picture p38: CAD file, 2026-09-26]
3d_models/changi_es1_rescue_stairs/stl/stair_only/ES1_stairs_8.4m_1-100_stair_only.stl
173.6 x 30.8 x 95.0
