Naz712/fleet_adapter_template/3d_models/changi_es1_rescue_stairs/track_print/cad/RB4107_track_unit_reviewed.step

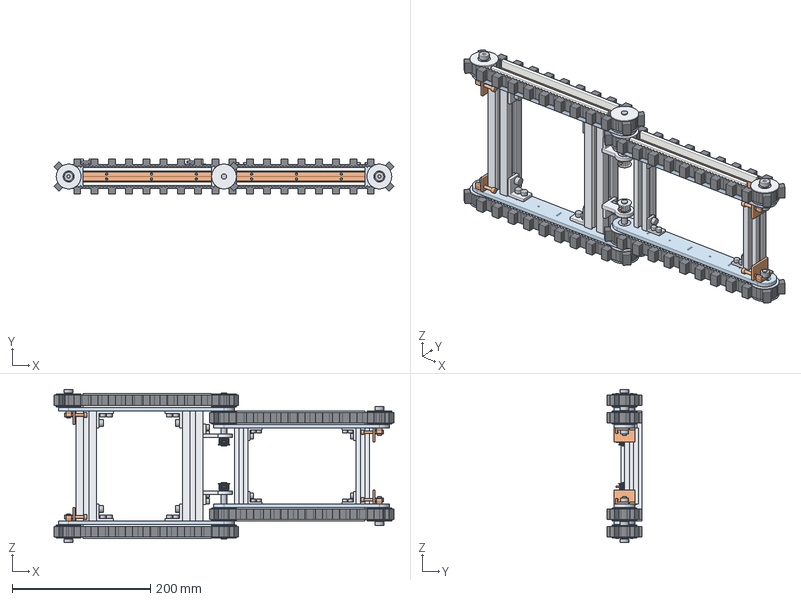
[picture p39: CAD file, 2026-10-18]
3d_models/changi_es1_rescue_stairs/track_print/cad/RB4107_track_unit_reviewed.step
492.4 x 50.0 x 222.0 mm
P2 side plate, rear A (reviewed: tab hole at +11, six carrier holes)
P2 side plate, rear B (reviewed: tab hole at +11, six carrier holes)
Bearing 688-2RS, P2 plate A (seat laser 15.8, reamed 16 H7)
Bearing 688-2RS, P2 plate B (seat laser 15.8, reamed 16 H7)
P8 bar 3030 x 160, rear
P8 bar 3030 x 160, middle
Corner bracket 3030, rear bar A
M6x10 SHCS, bracket into rear bar A
T-nut M6 slot 8, bracket in rear bar A
M5x8 SHCS, bracket into P2, rear bar A #1
M5x8 SHCS, bracket into P2, rear bar A #2
Corner bracket 3030, rear bar B
M6x10 SHCS, bracket into rear bar B
T-nut M6 slot 8, bracket in rear bar B
M5x8 SHCS, bracket into P2, rear bar B #1
M5x8 SHCS, bracket into P2, rear bar B #2
Corner bracket 3030, middle bar A
M6x10 SHCS, bracket into middle bar A
T-nut M6 slot 8, bracket in middle bar A
M5x8 SHCS, bracket into P2, middle bar A #1
M5x8 SHCS, bracket into P2, middle bar A #2
Corner bracket 3030, middle bar B
M6x10 SHCS, bracket into middle bar B
T-nut M6 slot 8, bracket in middle bar B
M5x8 SHCS, bracket into P2, middle bar B #1
M5x8 SHCS, bracket into P2, middle bar B #2
T-nut M5 slot 8, deck to rear bar #1
T-nut M5 slot 8, deck to rear bar #2
T-nut M5 slot 8, deck to rear bar #3
T-nut M5 slot 8, deck to rear bar #4
T-nut M5 slot 8, deck to middle bar #1
T-nut M5 slot 8, deck to middle bar #2
T-nut M5 slot 8, deck to middle bar #3
T-nut M5 slot 8, deck to middle bar #4
P17 hinge shaft support A (5 mm plate + 4 mm foot)
Bearing 688-2RS, P17 support A
M5x10 SHCS, P17 A into middle bar #1
M5x10 SHCS, P17 A into middle bar #2
P17 hinge shaft support B (5 mm plate + 4 mm foot)
Bearing 688-2RS, P17 support B
M5x10 SHCS, P17 B into middle bar #1
M5x10 SHCS, P17 B into middle bar #2
T-nut M5 slot 8, P17 A #1
T-nut M5 slot 8, P17 A #2
T-nut M5 slot 8, P17 B #1
T-nut M5 slot 8, P17 B #2
P1 side plate, front A (reviewed: tab hole at +11, six carrier holes)
P1 side plate, front B (reviewed: tab hole at +11, six carrier holes)
Bearing 688-2RS, P1 plate A (seat laser 15.8, reamed 16 H7)
Bearing 688-2RS, P1 plate B (seat laser 15.8, reamed 16 H7)
P7 bar 2020 x 110, hinge side
P7 bar 2020 x 110, nose
Corner bracket 2020, hinge-side bar A
M5x8 SHCS, bracket into hinge-side bar A
T-nut M5 slot 6, bracket in hinge-side bar A
M4x8 SHCS, bracket into P1, hinge-side bar A #1
M4x8 SHCS, bracket into P1, hinge-side bar A #2
Corner bracket 2020, hinge-side bar B
M5x8 SHCS, bracket into hinge-side bar B
T-nut M5 slot 6, bracket in hinge-side bar B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
