Naz712/fleet_adapter_template/3d_models/changi_es1_rescue_stairs/track_print/stl/spacer_rear_x4.stl

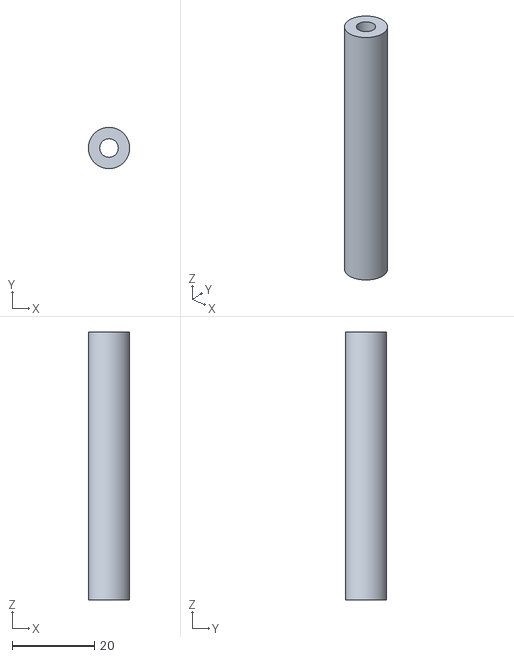
[picture p40: CAD file, 2026-10-14]
3d_models/changi_es1_rescue_stairs/track_print/stl/spacer_rear_x4.stl
10.0 x 10.0 x 65.0
