Naz712/fleet_adapter_template/3d_models/changi_es1_rescue_stairs/stl/ES1_stairs_5.8m_1-100.stl

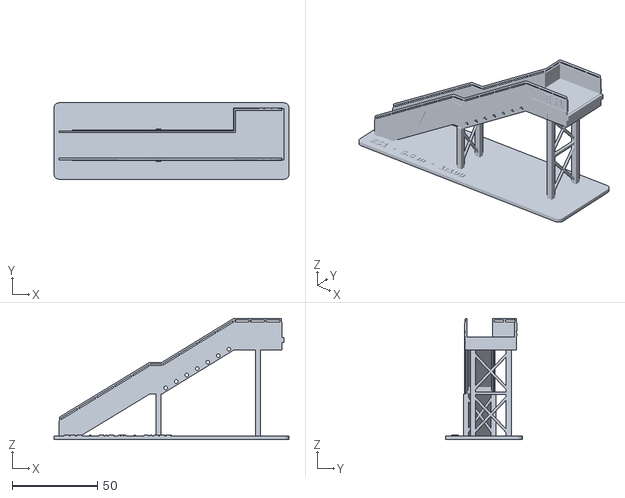
[picture p41: CAD file, 2026-09-26]
3d_models/changi_es1_rescue_stairs/stl/ES1_stairs_5.8m_1-100.stl
137.6 x 44.8 x 71.0
