Naz712/fleet_adapter_template/3d_models/changi_es1_rescue_stairs/stl/multicolour/ES1_stairs_5.8m_1-100/ES1_stairs_5.8m_1-100_lime.stl

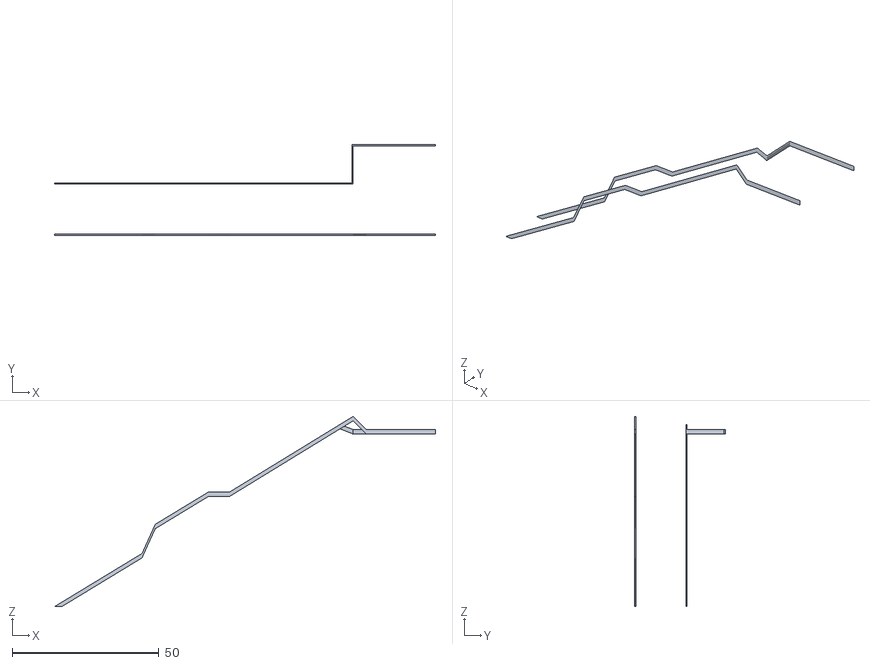
[picture p43: CAD file, 2026-09-26]
3d_models/changi_es1_rescue_stairs/stl/multicolour/ES1_stairs_5.8m_1-100/ES1_stairs_5.8m_1-100_lime.stl
129.7 x 30.8 x 64.8
