Naz712/fleet_adapter_template/3d_models/changi_es1_rescue_stairs/track_print/stl/side_plate_rear_R.stl

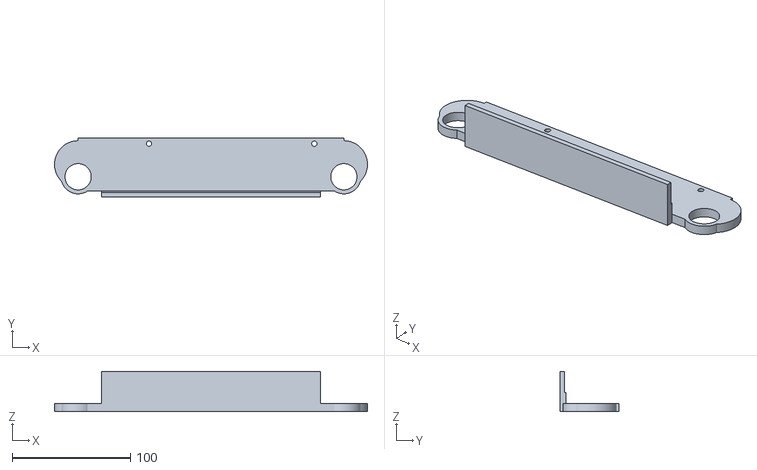
[picture p46: CAD file, 2026-10-13]
3d_models/changi_es1_rescue_stairs/track_print/stl/side_plate_rear_R.stl
265.0 x 50.3 x 34.0
