Naz712/fleet_adapter_template/3d_models/changi_es1_rescue_stairs/stl/ES1_stairs_3.2m_1-100.stl

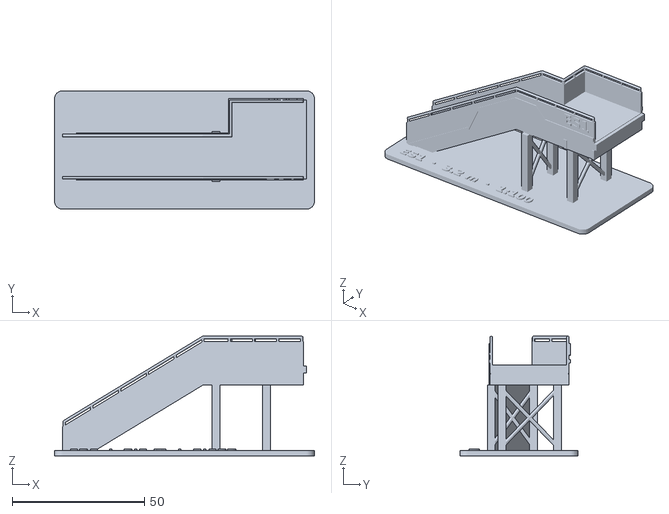
[picture p47: CAD file, 2026-09-26]
3d_models/changi_es1_rescue_stairs/stl/ES1_stairs_3.2m_1-100.stl
98.4 x 44.8 x 45.3
