Naz712/fleet_adapter_template/3d_models/changi_es1_rescue_stairs/stl/multicolour/ES1_stairs_3.2m_1-100/ES1_stairs_3.2m_1-100_red.stl

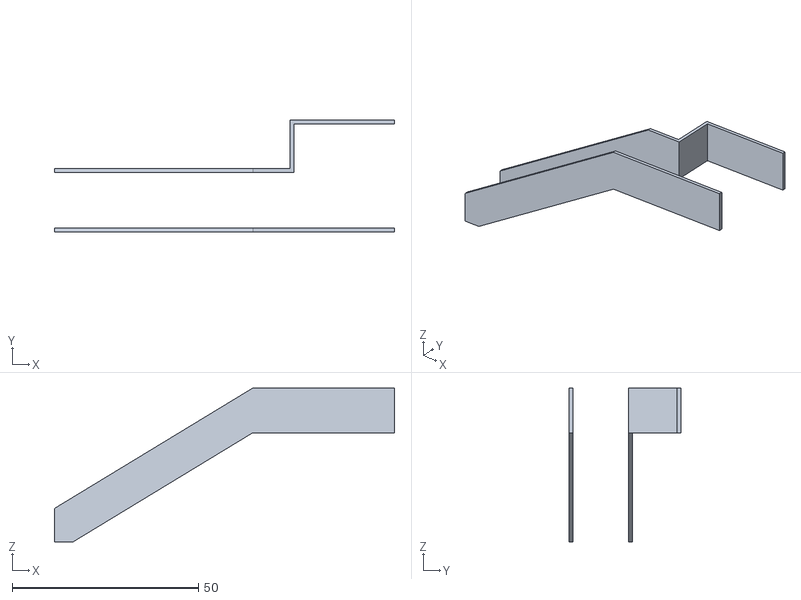
[picture p48: CAD file, 2026-09-26]
3d_models/changi_es1_rescue_stairs/stl/multicolour/ES1_stairs_3.2m_1-100/ES1_stairs_3.2m_1-100_red.stl
91.2 x 30.0 x 41.3
