Naz712/fleet_adapter_template/3d_models/changi_es1_rescue_stairs/stl/multicolour/ES1_stairs_3.2m_1-100_stair_only/ES1_stairs_3.2m_1-100_stair_only_grey.stl

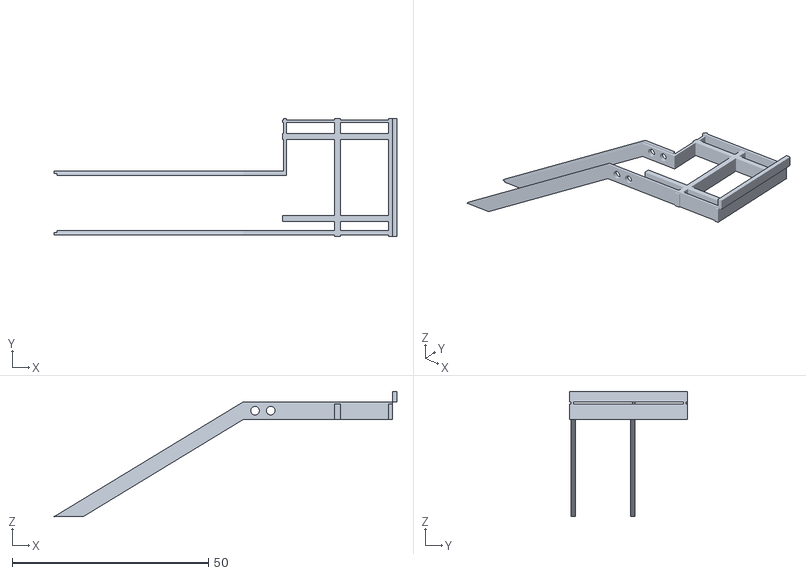
[picture p49: CAD file, 2026-09-26]
3d_models/changi_es1_rescue_stairs/stl/multicolour/ES1_stairs_3.2m_1-100_stair_only/ES1_stairs_3.2m_1-100_stair_only_grey.stl
87.5 x 30.0 x 32.0
