Naz712/fleet_adapter_template/3d_models/changi_es1_rescue_stairs/track_print/stl/spacer_rear_x2.stl

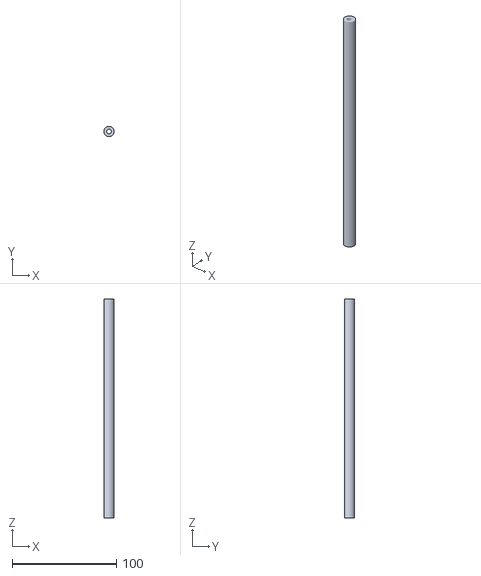
[picture p54: CAD file, 2026-10-13]
3d_models/changi_es1_rescue_stairs/track_print/stl/spacer_rear_x2.stl
10.0 x 10.0 x 210.0
