Naz712/fleet_adapter_template/3d_models/changi_es1_rescue_stairs/stl/multicolour/ES1_stairs_5.8m_1-100/ES1_stairs_5.8m_1-100_silver.stl

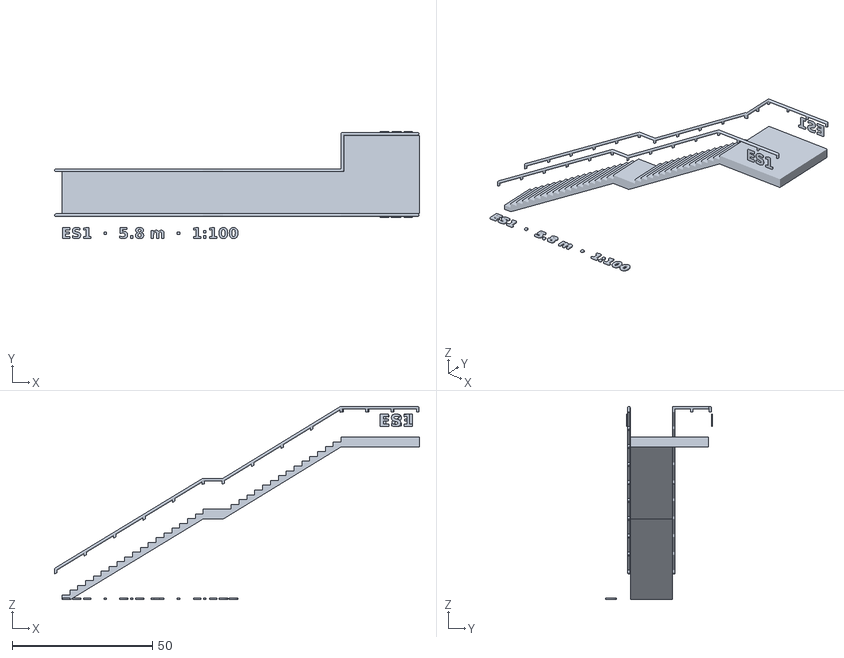
[picture p56: CAD file, 2026-09-26]
3d_models/changi_es1_rescue_stairs/stl/multicolour/ES1_stairs_5.8m_1-100/ES1_stairs_5.8m_1-100_silver.stl
130.2 x 38.3 x 69.0
