Naz712/fleet_adapter_template/3d_models/changi_es1_rescue_stairs/stl/multicolour/ES1_stairs_5.8m_1-100_stair_only/ES1_stairs_5.8m_1-100_stair_only_grey.stl

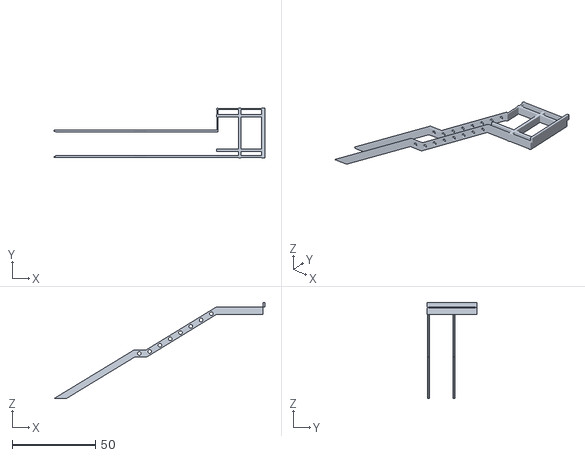
[picture p57: CAD file, 2026-09-26]
3d_models/changi_es1_rescue_stairs/stl/multicolour/ES1_stairs_5.8m_1-100_stair_only/ES1_stairs_5.8m_1-100_stair_only_grey.stl
126.7 x 30.0 x 57.7
