Naz712/fleet_adapter_template/3d_models/changi_es1_rescue_stairs/stl/multicolour/ES1_stairs_8.4m_1-100/ES1_stairs_8.4m_1-100_silver.stl

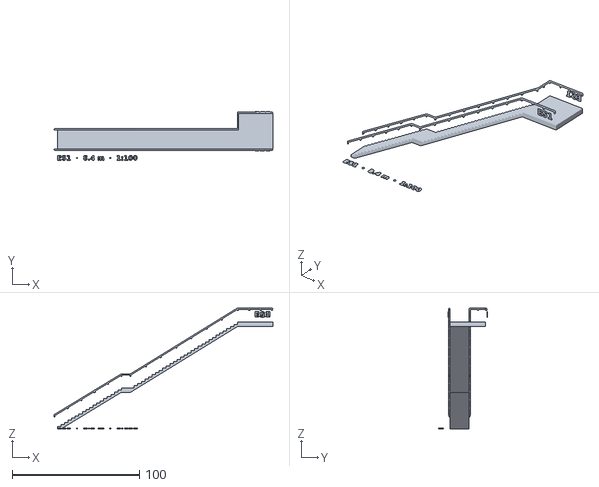
[picture p58: CAD file, 2026-09-26]
3d_models/changi_es1_rescue_stairs/stl/multicolour/ES1_stairs_8.4m_1-100/ES1_stairs_8.4m_1-100_silver.stl
172.3 x 38.3 x 95.0
