Naz712/fleet_adapter_template/3d_models/changi_es1_rescue_stairs/track_print/stl/side_plate_front_L.stl

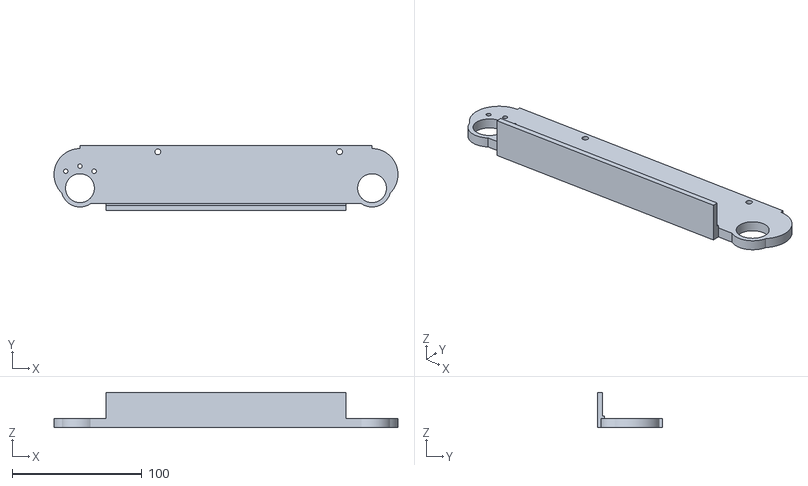
[picture p59: CAD file, 2026-10-13]
3d_models/changi_es1_rescue_stairs/track_print/stl/side_plate_front_L.stl
265.0 x 50.3 x 27.0
