Naz712/fleet_adapter_template/3d_models/changi_es1_rescue_stairs/track_print/stl/stand_in_pulley_20T_PLA_test_only.stl

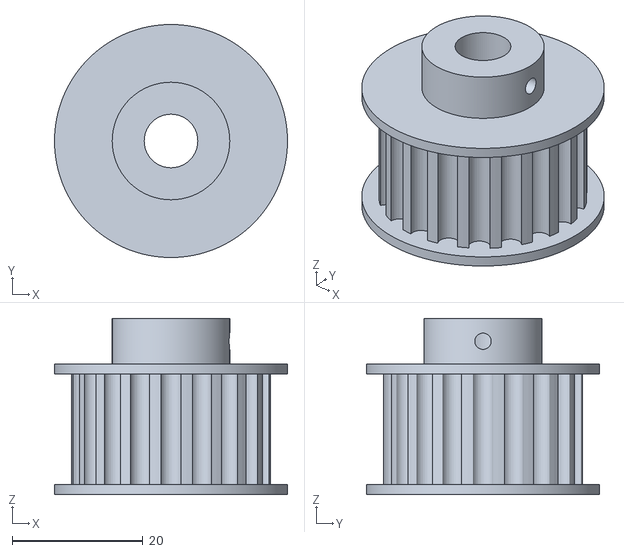
[picture p61: CAD file, 2026-10-13]
3d_models/changi_es1_rescue_stairs/track_print/stl/stand_in_pulley_20T_PLA_test_only.stl
35.7 x 35.7 x 27.0
