Naz712/fleet_adapter_template/3d_models/changi_es1_rescue_stairs/track_print/stl/track_TPU_x4.stl

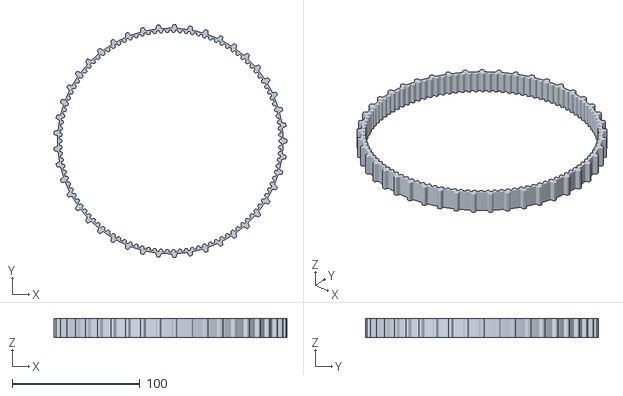
[picture p62: CAD file, 2026-10-11]
3d_models/changi_es1_rescue_stairs/track_print/stl/track_TPU_x4.stl
182.6 x 182.7 x 15.0
