Naz712/fleet_adapter_template/3d_models/changi_es1_rescue_stairs/track_print/stl/fit_test_track_5mm_TPU.stl

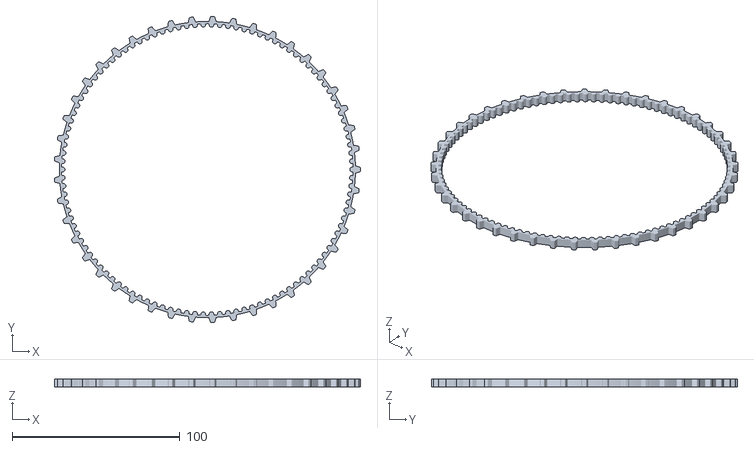
[picture p63: CAD file, 2026-10-11]
3d_models/changi_es1_rescue_stairs/track_print/stl/fit_test_track_5mm_TPU.stl
182.6 x 182.7 x 5.00
