Naz712/fleet_adapter_template/3d_models/changi_es1_rescue_stairs/track_print/stl/sprocket_middle_double_PETG_x2.stl

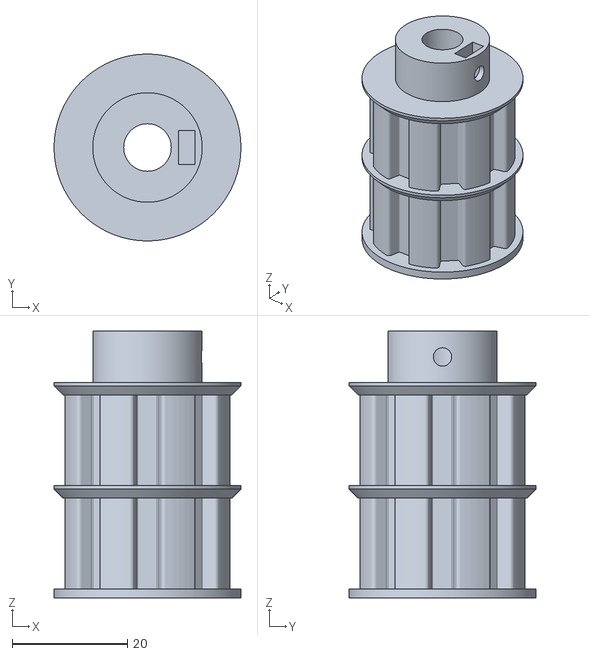
[picture p64: CAD file, 2026-10-09]
3d_models/changi_es1_rescue_stairs/track_print/stl/sprocket_middle_double_PETG_x2.stl
32.4 x 32.4 x 46.3
