Naz712/fleet_adapter_template/3d_models/changi_es1_rescue_stairs/track_print/stl/step_gauge_3_steps_1-5_PLA.stl

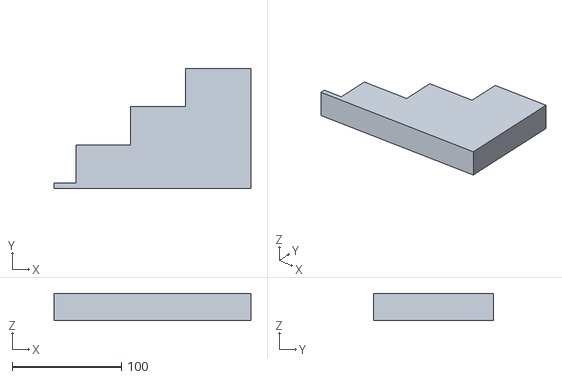
[picture p65: CAD file, 2026-10-09]
3d_models/changi_es1_rescue_stairs/track_print/stl/step_gauge_3_steps_1-5_PLA.stl
180.0 x 110.0 x 25.0
