Naz712/fleet_adapter_template/3d_models/changi_es1_rescue_stairs/track_print/stl/sprocket_end_PETG_x4.stl

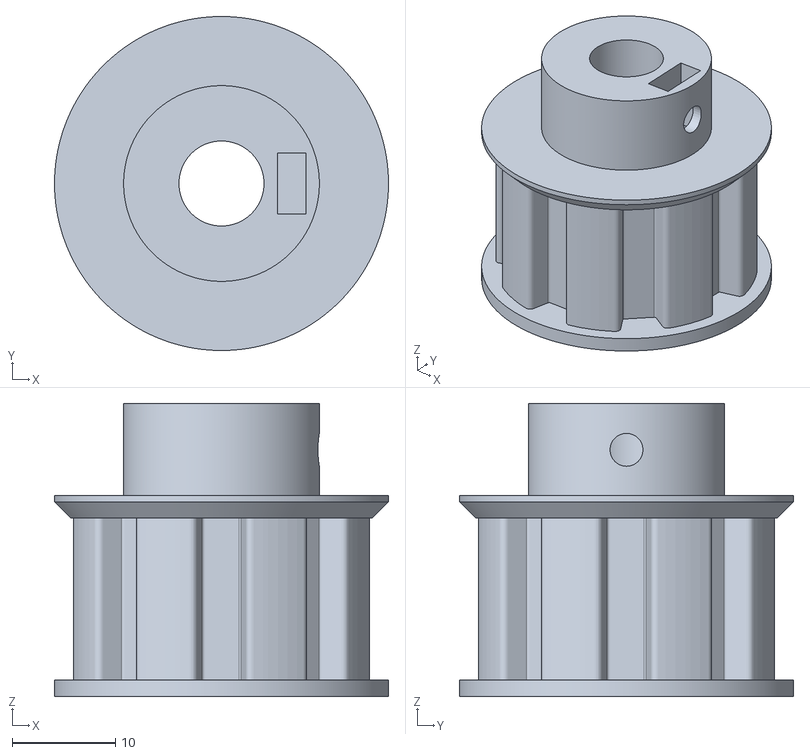
[picture p66: CAD file, 2026-10-09]
3d_models/changi_es1_rescue_stairs/track_print/stl/sprocket_end_PETG_x4.stl
32.4 x 32.4 x 28.5
