Naz712/fleet_adapter_template/(list of files, cad)

Other CAD files:
3d_models/changi_es1_rescue_stairs/stl/multicolour/ES1_stairs_3.2m_1-100/ES1_stairs_3.2m_1-100_lime.stl
3d_models/changi_es1_rescue_stairs/stl/multicolour/ES1_stairs_5.8m_1-100_stair_only/ES1_stairs_5.8m_1-100_stair_only_lime.stl
3d_models/changi_es1_rescue_stairs/stl/multicolour/ES1_stairs_8.4m_1-100_stair_only/ES1_stairs_8.4m_1-100_stair_only_lime.stl
3d_models/changi_es1_rescue_stairs/stl/multicolour/ES1_stairs_5.8m_1-100_stair_only/ES1_stairs_5.8m_1-100_stair_only_red.stl
3d_models/changi_es1_rescue_stairs/stl/multicolour/ES1_stairs_3.2m_1-100_stair_only/ES1_stairs_3.2m_1-100_stair_only_red.stl
3d_models/changi_es1_rescue_stairs/stl/multicolour/ES1_stairs_8.4m_1-100_stair_only/ES1_stairs_8.4m_1-100_stair_only_red.stl
3d_models/changi_es1_rescue_stairs/track_print/stl/side_plate_front_R.stl
3d_models/changi_es1_rescue_stairs/track_print/stl/side_plate_rear_L.stl
