Naz712/fleet_adapter_template/3d_models/changi_es1_rescue_stairs/track_print/viewer/index.html

# RB4107 Track Assembly

1:5 prototype on Nhien's Rev B frame, with my printed track or the bought belt. Drag to orbit, scroll to zoom, click a part.

Assembledone

Hinge0°

Show

Zoom to

Track

ES1 stairs

Fade fasteners

Deck slot H +3 mm

Reset view

Pull the Assemble slider left to take it apart, then push it right to put it together one connection at a time. Numbers are the joints; the panel names the fasteners for the joint being made. Double-click a part to zoom to it; the Zoom menu jumps to the hinge, idlers, drive or deck.

Loading the model (7 MB)…
