Naz712/fleet_adapter_template/3d_models/changi_es1_rescue_stairs/track_print/assembly/Track_unit_assembly_in_detail.pdf

# Track unit assembly, in detail

Only the track side of the RB4107 1:5 carrier: the toothed wheels, how each one is fixed to its shaft, how the shaft is held in place, the idler wheels on their shoulder screws, the tensioner, and how the track loop goes on and is set. The frame, deck, drive train and electronics are left out; they are in the full plan. Everything here is for one side; the other side is the same, mirrored. Dimensions are in millimetres and come from the shared 3D model (Nhien's Rev B with the track added, reviewed 16 to 18 October 2026).


Fig. 1a The hinge shaft of one side with its three toothed parts: rear hinge wheel outside the rear plate, front hinge wheel in the lane between the plates, stage-2 pulley inboard of the P17 support. This shaft is the drive shaft: the stage-2 belt turns it, the two wheels drive the two track loops.


Fig. 1b The nose end: idler wheel on its shoulder screw in the plate slot, the tensioner tab and slider, the rail ending short of the wheel.

## WHAT IS IN ONE SIDE'S TRACK UNIT

PART

QTY PER
SIDE
| WHAT IT DOES | HOW IT IS FIXED

Hinge wheels, HTD 5M 20T for 15 mm belt, flanged, bore reamed 8 H7 (TS-06)

2 | Drive the front and the rear track loops; the front one also locates the shaft | Ø2.5 spring pin through hub and shaft, at mid-face, flush

Stage-2 pulley M3 (Nhien's, HTD 5M 9 wide), bore 8 H7

1 | Brings the drive from the motor belt onto the shaft | Spring pin, or a cone-point set screw into a seat drilled in the shaft (section 1.3)

Hinge shaft P20, Ø8 h7 plain round, A 82.3 / B 77.3

1 | Carries the three parts above, turns in three 688 bearings | Held along its axis by the pinned front wheel between the P1 and P2 bearings; nothing else

Bearings 688-2RS (8 x 16 x 5) in P2, P1 and P17

3 | The shaft turns in them | Pressed into seats laser-cut 15.8 and reamed 16 H7, Loctite 641

Shims 8 x 11: 0.5 (front wheel) and 1.0 (stage-2 pulley)

1 + 1 | Keep the wheel and pulley faces off the bearings' outer rings | Trapped between the pinned part and the bearing's inner ring

Idler wheels, same HTD 5M 20T, bored 16 H7 for two 688s with an 8 x 10 x 9 sleeve

2 (nose, rear) | Free-running far wheel of each loop; the tensioner moves it | On an ISO 7379 Ø8 x 25 M6 shoulder screw through the plate slot

Shoulder screw set: head washer 8 x 11 x 1, 0.5 shim, slider TS-09, M6 nyloc

2 sets | The stub axle of the idler and its clamp | Nyloc 7 N·m once tensioned; slider replaces the washer under the nut

Tensioner tab TS-09 with M3 x 6 and M4 x 20 jack screw

2 | Pushes the idler out along the slot and holds that position while the nut is tightened | M3 into the plate's new tapped hole at (±223, +11), Loctite 243

Track loops: option A printed TPU (TS-01) or option B HTD 550-5M-15 belt with 22 bonded cleats

2 | The track | Teeth in the wheel grooves; tension only

Slide rails P3 to P6 (UHMW 186 x 20 x 5) on carrier angles TS-10

2 + 2 per
segment

The runs slide on them so the loop stays straight under load

Carrier angle M3 x 6 into the plate (3 off), rail 3 x 5 thread-forming into the angle

## 1. THE HINGE SHAFT AND WHAT IS FIXED TO IT

Each side has one shaft. It is also the drive shaft, so three toothed parts turn with it: the rear hinge wheel (outside the rear plate P2), the front hinge wheel (in the 20 mm lane between P2 and the front plate P1) and the stage-2 pulley (inboard of the P17 support). The shaft runs in three 688 bearings, one in each of P2, P1 and P17. Fig. 2 shows the whole stack.

lane 20.0 between the plate faces = wheel 19 + shim 0.5 + gap 0.5
Front hinge wheel, pinned FIRST: it locates the shaft
Rear hinge wheel, pinned | | Stage-2 pulley, pinned (or seated set screw)
P2 plate, 688 bearing | P1 plate, 688 | P17 support, 688

0.3 to 0.5 gap, rear wheel to the P2 bearing
0.3 to 0.5 feeler gap, front wheel to the P2 bearing
0.5 shim against the P1 bearing | 1 mm shim against the P17 bearing
shaft end 1.5 mm proud of the wheel face | 1.5 mm proud of the pulley face
Plain round shaft Ø8 h7, 82.3 long (side A; side B is 77.3).
Three Ø2.5 spring pins at mid-face, driven flush. No flats, no grooves, no E-clips.
OUTSIDE the machine | INBOARD, towards the middle

Fig. 2 One hinge shaft seen from above, side A, drawn to scale along the shaft. Everything that must not move is pinned to the shaft; the shaft itself is held by the pinned front wheel sitting between the P1 and P2 bearings.

### 1.1 How each wheel and pulley is fixed to the shaft: the cross pin

One ISO 8752 spring pin through the hub and the shaft (2.5 x 24 in the hinge wheels; 2.5 x 16 in the stage-2 pulley, which is only Ø17.5) at the middle of the toothed face, driven flush on both sides. The pin does two jobs at once: it makes the part turn with the shaft (torque goes through the pin in double shear, which carries many times the 60 N this drive puts on it), and it stops the part sliding along the shaft, because the pin is in the shaft too. Nothing else holds the wheels: no grub screw, no flat on the shaft, no E-clip groove.
Why not a set screw on the wheels. The hinge wheels fill the 20 mm lane at 19 mm over their flanges with 0.5 mm each side, so they have no hub boss. A set screw would have to go through the toothed rim, under the track, with no way to reach it once the track is on. And on a plain round shaft a set screw holds only by friction: an M3 or M4 cup point gives about 1 to 1.5 N·m against 0.25 N·m running and 0.75 N·m in a shock, it works loose when the drive reverses, and its burr stops the shaft pulling back out through the bearings. The reviewer's set screw is right where there is a hub for it; that is the stage-2 pulley, in 1.3. Why not a D-flat or an E-clip. A flat fixes rotation but not position along the shaft, so the clips come back; a 70 mm milled flat weakens the shaft; an E-clip groove cuts the Ø8 shaft to Ø6 where it bends most. The pin hole sits beside a bearing where bending is small: an Ø8 shaft with a Ø2.5 hole keeps about half its section modulus and runs at about 40 MPa against a yield above 350 MPa.

### 1.2 How the shaft is held in place along its axis

The front hinge wheel is pinned first, sitting in the lane with its 0.5 mm shim against the P1 bearing's inner ring and a 0.3 to 0.5 mm feeler gap to the P2 bearing. Once that pin is in, the shaft cannot move more than the feeler gap in either direction, because the wheel is trapped between the two plate bearings and the shaft is pinned to the wheel. That is the whole axial location. The rear wheel and the stage-2 pulley are then pinned where they stand, each with its own small gap or shim to the bearing beside it, and the shaft ends stand 1.5 mm proud of the outer faces. The rear wheel is the part at the very end of the shaft: its pin is what keeps it there; nothing can walk off because nothing is free on the shaft.
Check after pinning: push and pull the front wheel; it moves only by the feeler gap. A strip of paper passes between every wheel face and the bearing's outer ring next to it; if it does not, the face rubs the ring and the bearing drags.

### 1.3 The stage-2 pulley: pin, or a seated set screw

Nhien's pulley M3 has a hub boss with a tapped hole, outside the belt width, in the open space inboard of P17. Two ways are good; pick one and do the same on both sides.
Pin, exactly as the wheels: the tapped hole is drilled through to Ø2.5 on the press (the thread goes), the far side of the hub is drilled through it, and the shaft is drilled through both in place (procedure 1.4). Nothing to come loose, nothing sticking out.

Seated set screw. Push the pulley against its 1 mm shim, then through the tapped hole spot-drill the shaft with a Ø3 drill point about 1 mm deep, in place, exactly as the pin hole would be drilled. Fit an M4 cone-point set screw with Loctite 243 and tighten to about 1 N·m. The cone sits in the seat, so the screw takes the torque in bearing (well over 2 N·m) and holds the pulley along the shaft; without the seat it would be friction only. Never a hole bigger than Ø3 into an Ø8 shaft.
A screw right through the hub and the shaft (M3 x 30 with a nyloc through a Ø3.2 hole) also works and is removable with tools, as long as the head and the nut clear the belt and the P17 support as the pulley turns.

### 1.4 Procedure: pinning the three parts to the shaft (2 hours for both sides)

What you are doing. The pin hole through the shaft is drilled with the parts in place, because the wheels sit between the plates and the shaft only ever goes in through the bearings. The hole in each hub was drilled on the drill press beforehand (when the bore was reamed: Ø2.5 through both walls at mid-face, 9.5 from a flange face, centre-punched first) and now serves as the drill guide. That is what keeps a hand-drilled hole straight.
Tools. Cordless drill with a sharp long-series Ø2.5 HSS bit (two new ones in the kit), cutting fluid, 2.5 mm pin punch and a small hammer, feeler gauges 0.3 and 0.5, the shims, two G-clamps, a marker, a strip of paper.
1. The frame sits on the bench with its plates clamped down, no deck yet, so every hub hole is reachable from above. Mark each hub hole with the marker so you can find it when the wheel is in the lane.
2. Put the shaft in from outside, chamfered end first: through the rear wheel, the P2 bearing, the front wheel with its 0.5 shim on the P1 side, the P1 bearing, the P17 bearing, the 1 mm shim and the stage-2 pulley. Push until the outer end stands 1.5 mm proud of the rear wheel's outer face.
3. Front wheel first, because it locates the whole shaft. Push the wheel and its shim gently against the P1 bearing. Slide the 0.3 feeler between the wheel's other face and the P2 bearing: it must go in with a light drag. The 0.5 must not. If the 0.5 goes in, the lane is too wide (check the bars); if the 0.3 will not, the lane is too narrow.
4. Turn the wheel so its hub hole points straight up. Hold it there by its flange; the shaft is free to turn, so make sure the hub hole and nothing else is what the drill meets.
5. Oil on the bit. Put the bit into the hub hole, sight along the plate so the drill is square to the shaft, and drill with steady pressure. You feel it cut aluminium for a moment, then steel; keep the speed moderate and let it cut. When it breaks through the far side of the shaft it enters the far hub hole: ease off. Pull out, clear the chips, blow out the hole.
6. Start a spring pin with the hammer, then drive it with the punch until it sits the same depth both sides, about 3 mm below the tooth roots. It must not stand up into a tooth space on either side, or the track will click over it.
7. Check: the shaft turns freely by hand with the wheel; pushing and pulling the wheel moves it only by the feeler gap; the strip of paper passes between the wheel face and the bearing's outer ring on both sides.
8. Rear wheel. Slide it so the 0.3 feeler passes between its inner face and the P2 bearing and the 0.5 does not. Hub hole up, drill, pin, check.
9. Stage-2 pulley. Push it and its 1 mm shim against the P17 bearing's inner ring. Hub hole up, drill, pin (or spot-drill and set screw, 1.3), check.
10. Other side the same. Final check for the side: the shaft turns freely with its three parts; runout over the wheel teeth under 0.1 mm against a fixed pointer; the front frame still swings 0 to 35°.
Mistakes to avoid. Drilling without the hub hole as a guide (the hole wanders, the pin is loose, the wheel knocks under load). Forgetting a shim before the shaft goes in (everything comes out again). Driving the pin too far (it pokes into the tooth space on the far side). A dull bit: a 2.5 mm drill that is not cutting steel within a few seconds is blunt; change it before it snaps.
If a pin ends up loose. Drill a second pair of hub holes at 90° to the first on the drill press, with the wheel off on a spare piece of shaft, and pin again. On the assembled machine that means the shaft comes out, which is why the practice run on scrap (a spare wheel and 100 mm of spare shaft are in the order) is worth the hour.


Fig. 3 The hinge wheel as bought (MISUMI HTD 5M 20T for 15 mm belt, flanged), with the bore reamed 8 H7 and the Ø2.5 hub hole at mid-face.

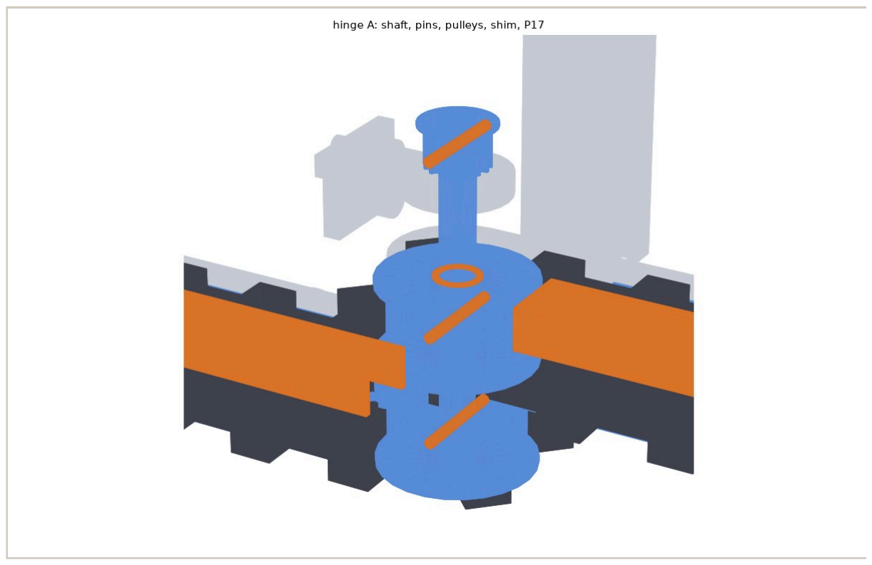
[picture p138: figure]

Fig. 4 Solid-model check at the hinge: plates, bearings, wheels, shims and the pinned shaft, nothing touching that should not.

SHEET TS-11: WHERE EVERY PART SITS ALONG THE HINGE SHAFT AND THE IDLER SCREW, WITH THE FITS


## HOW TO READ TS-11


## SHEET TS-06: THE TOOTHED WHEEL, REAMED BORE AND CROSS PIN


## HOW TO READ TS-06


## 2. THE IDLER WHEELS ON THEIR SHOULDER SCREWS

The far wheel of each loop (at the nose for the front segment, at the tail for the rear one) is an idler: it carries no drive, it only guides the loop and takes the tension. It turns on two 688 bearings on an ISO 7379 shoulder screw, Ø8 x 25 with an M6 thread, which passes through the slot in the plate. The screw is the idler's stub axle; the slot lets the axle move 9.6 mm along the plate for tensioning.

### 2.1 The stack on the shoulder screw, from the head

ORDER PART | THICKNESS WHY IT IS THERE
1 | Head washer 8 x 11 x 1 | 1 | Keeps the screw head off the bearing's outer ring; it bears on the inner ring only
2 | Bearing 688-2RS, outer | 5 | Pressed in the wheel (bore 16 H7, light press)
3 | Sleeve 8 x 10 x 9, aluminium | 9 | Between the two inner rings, so the nut can clamp them without squeezing the wheel
4 | Bearing 688-2RS, inner | 5 | Second bearing: the wheel runs on two, no rock
5 | Shim 8 x 11 x 0.5 | 0.5 | Keeps the wheel's inner flange off the plate and the rail's carrier
6 | Plate P1 or P2, through the slot 8.1 x 20.3 | 5 | The Ø8 shank sits in the 8.1 slot with 0.1 to 0.15 clearance
7 | Slider TS-09 (Ø6.4 hole on the thread) | 3 | Replaces the plain M6 washer; its foot is what the jack screw pushes
8 | M6 nyloc nut | 5 | Clamps plate, shim and the two inner rings against the head at 7 N·m; the outer rings and the wheel stay free

The stack on the 25 mm shoulder is 1 + 5 + 9 + 5 + 0.5 = 20.5, plus the 5 mm plate: the shoulder ends 0.5 mm inside the plate, so the nut tightens the inner-ring stack solid against the head and never pinches the wheel. With the 3 mm slider in place of the 1.6 mm washer, 1.5 mm of thread still shows past the nut. The wheel must spin free with the nut tight; if it does not, a bearing is seated crooked or the sleeve is missing.

### 2.2 Where the idler can sit

The slot runs from x 220.4 to 232.6 (screw centres, measured from the hinge axis). The rail ends at 207 and its carrier angle at 204, and the wheel's flange reaches 16 mm inboard of the screw centre, so the idler must never sit closer to the hinge than x 223 or the flange hits the rail end. The usable travel is therefore 223 to 232.6: 9.6 mm of axle movement, which takes up 19 mm of loop. Measured from the plate's nose end at x 240.2, that is 17.2 mm down to 7.6 mm.


Fig. 5a The idler set: shoulder screw, head washer, the two bearings with the sleeve between them, the 0.5 shim, the slider and the nyloc.


Fig. 5b The tensioner set that goes with it: the tab with its ear and the jack screw, and the slider with its foot.

## 3. THE TENSIONER: HOW IT WORKS

The track loop is tight when the idler is pushed out along its slot. Rev B relied on the nut's friction alone to hold the idler wherever a hand had put it, which is why the reviewer said the track would be loose: nothing set the tension and nothing kept it. TS-09 adds a pusher and a lock at each idler, four sets per machine.

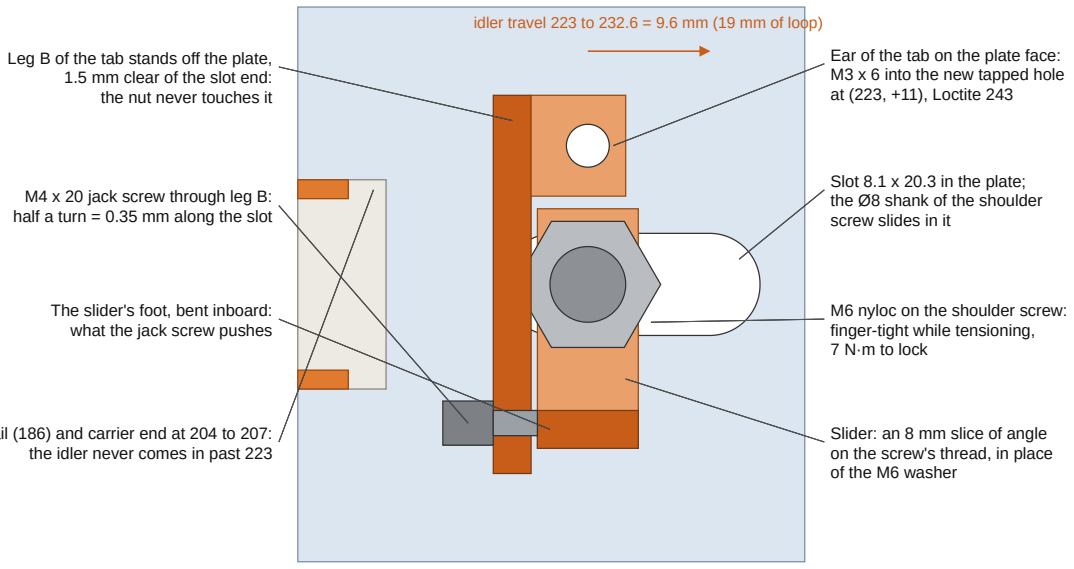
[picture p139: figure]
Leg B of the tab stands off the plate, 1.5 mm clear of the slot end: the nut never touches it; M4 x 20 jack screw through leg B: half a turn = 0.35 mm along the slot; The slider's foot, bent inboard: what the jack screw pushes; the idler never comes in past 223; Ear of the tab on the plate face: M3 x 6 into the new tapped hole at (223, +11), Loctite 243; Slot 8.1 x 20.3 in the plate; the Ø8 shank of the shoulder screw slides in it; M6 nyloc on the shoulder screw: finger-tight while tensioning, 7 N·m to lock; Slider: an 8 mm slice of angle on the screw's thread, in place of the M6 washer

idler travel 223 to 232.6 = 9.6 mm (19 mm of loop)

Rail (186) and carrier end at 204 to 207:

Fig. 6 How the tensioner works, to scale: the inboard face of plate P1 at the nose end (the shoulder screw head and the idler wheel are on the far side). The tab is fixed to the plate; the jack screw turns in the tab and pushes the slider's foot; the slider sits on the shoulder screw, so the idler moves out along the slot and the loop tightens. The nut then locks the shoulder screw; the jack screw is backed off a quarter turn and carries nothing.

### 3.1 The three parts

The tab. A 30 mm length of 20 x 20 x 3 aluminium angle. One leg is cut back to a 7.5 x 8 ear that lies on the plate's inboard face and is screwed to it with an M3 x 6 into the new tapped hole at (±223, +11), Loctite 243, 1.0 N·m. The other leg, leg B, stands off the plate at right angles, 1.5 mm on the hinge side of the slot end, so the nut's corners never touch it as the idler travels. Leg B carries an M4 tapped hole at the height of the slider's foot (6 mm off the plate face, 11 mm below the slot centreline).
The slider. An 8 mm wide slice of the same angle. Its 19 mm leg lies on the plate over the slot with a Ø6.4 hole 13 mm from its bottom, so it sits on the shoulder screw's M6 thread under the nut, in place of the plain washer. Its short leg, 8 mm, is bent inboard at the bottom: the foot.
The jack screw. An M4 x 20 socket head screw through the tapped hole in leg B, tip against the foot, turned with a 3 mm key from the hinge side, under the bar.

### 3.2 What happens when you turn it

The tab cannot move: it is screwed to the plate. The jack screw advances through leg B by 0.7 mm per turn (the M4 pitch), so each half turn pushes the foot, and with it the slider, the shoulder screw and the idler wheel, 0.35 mm outward along the slot. The loop passes over the idler, so pushing the idler out stretches the loop: 1 mm of idler travel takes up 2 mm of loop. When the deflection is right, the nyloc is tightened to 7 N·m with the screw head held by its 4 mm key: now the nut and the clamped stack hold the idler, by far more force than the belt pull. The jack screw is then backed off a quarter turn so that it carries no load, and stays there as the stop for the next re-tension.

### 3.3 How tight is right, and how to measure it

The rails sit directly under both runs of the loop, so pushing a run inward moves nothing and tells you nothing. Pull a run away from its rail instead: with the machine on blocks, hook a cleat of the lower run at mid-span (about 110 mm from either wheel) with a bent wire on a small spring scale and pull it away from the machine with 4 N, about 400 g, reading the movement against a steel rule held beside it. The printed TPU track should give 2 to 3 mm; the stiffer belt of option B, 1.5 to 2.5 mm. Less than that loads the bearings and makes a TPU loop creep faster; more than that and the teeth ride up under load and skip.


Fig. 7 The tensioner on the solid model, nose A, from inboard: tab standing off the plate (orange), jack screw on the slider's foot, shoulder screw and nut in the slot, carrier angle below.


Fig. 8 The same corner as drawn on TS-09, plan from inboard: slot, shoulder screw and nut, slider, tab with its ear and M3, jack screw on the foot, and the rail and carrier ending short of the wheel.

Idler travel 223 to 232.6 (9.6 mm, 19 mm of loop). Half a turn of the jack screw = 0.35 mm. Deflection 2 to 3 mm (TPU) or 1.5 to 2.5 mm (belt) at 4 N on the lower run at mid-span. Nyloc 7 N·m with the screw head held. Jack screw backed off a quarter turn after locking. A TPU loop settles 1 to 2 % in its first days: re-check after the first run and after a day.

## SHEET TS-09: IDLER TENSIONER, TAB, SLIDER AND JACK SCREW


## HOW TO READ TS-09


## 4. FITTING THE TRACK LOOP AND SETTING THE TENSION

This is assembly steps 10 and 11 of the plan, for one loop; four loops per machine, the two of one side set to the same feel. Before this, each loop has been fit-checked on two wheels at 223 mm centres (option A, the printed TPU loop: the fit-test slice and then the rings; option B: the belt back from the belt shop with its cleats).

### 4.1 Parts for one loop

The idler wheel with its two bearings and sleeve already pressed in; the shoulder screw, head washer 8 x 11 x 1, shim 8 x 11 x 0.5, slider, M6 nyloc; the tab with its M3 x 6 and M4 x 20 jack screw; the loop. Tools: 4 mm hex key (shoulder screw head), 10 mm spanner (nyloc), 2.5 mm key (M3), 3 mm key (jack screw), the hook and spring scale, a steel rule, Loctite 243.

### 4.2 Procedure

1. Put the idler wheel inside the loop and hang the loop over the hinge wheel, teeth into the grooves, so the idler sits near its slot in the plate.
2. Build the shoulder screw stack from the head: head washer, through the idler's two bearings and sleeve, the 0.5 shim, through the plate slot, the slider with its foot pointing inboard and down, the nyloc finger-tight only. Push the idler toward the hinge until the screw sits at x 223: that is 17.2 mm from the plate's nose end, and no closer, because the rail ends there.
3. Fit the tab: ear onto the plate's tapped hole with the M3 x 6 and a drop of 243, 1.0 N·m. Leg B stands 1.5 mm off the slot end on the hinge side. Run the M4 jack screw through the tapped leg until its tip touches the slider's foot.
4. Turn the jack screw clockwise in half turns. Each half turn moves the idler 0.35 mm outward. After each, pull the lower run with the hook and scale at mid-span and read how far it comes away from the rail. Stop at 2 to 3 mm (TPU) or 1.5 to 2.5 mm (belt).
5. Lock it: 4 mm key in the shoulder screw head so it cannot turn, 10 mm spanner on the nyloc, 7 N·m (snug plus a quarter turn with the long leg of the key is close). The nut clamps the plate between the slider and the shim.
6. Back the jack screw off a quarter turn so it carries no load; the nut holds the position now.
7. Turn the loop one full turn by hand. Listen: no clicks (a click is a tooth riding up or a pin standing proud). Look: the cleats clear the deck (option A by 5 mm; option B runs through the deck notch), the loop runs centrally between the flanges without walking, the flanges clear the rail end by at least 2 mm and the bar end by 3.7.
8. Do the other loop of the same side to the same deflection, then the other side.
9. Re-check the deflection after the first run and again after a day. A TPU loop settles; if it reads over 3 mm, loosen the nut, half a turn on the jack screw, tighten again. That is the whole re-tensioning job.

### 4.3 Checks before the first run

Shoulder screw centre between 223 and 232.6, measured from the plate's nose end as 17.2 down to 7.6 mm.
The idler spins free with the nut tight; the hinge wheel turns the loop by hand with no tight spot once a turn (a tight spot means a pin proud or a bearing crooked).
Each side on blocks under power: no tooth jump when the loop is braked by hand.


Fig. 9 The loop: option A is the printed TPU track, 110 HTD 5M teeth inside, 45 cleats outside, five cleats per ES1 step; option B is a bought HTD 550-5M-15 belt with 22 bonded cleats.


Fig. 10 Steps 8 to 10 in the interactive model: the idlers go on last, through the plate slots, with the sliders, nuts and tabs.

## SHEET TS-01: THE PRINTED TRACK LOOP (OPTION A)

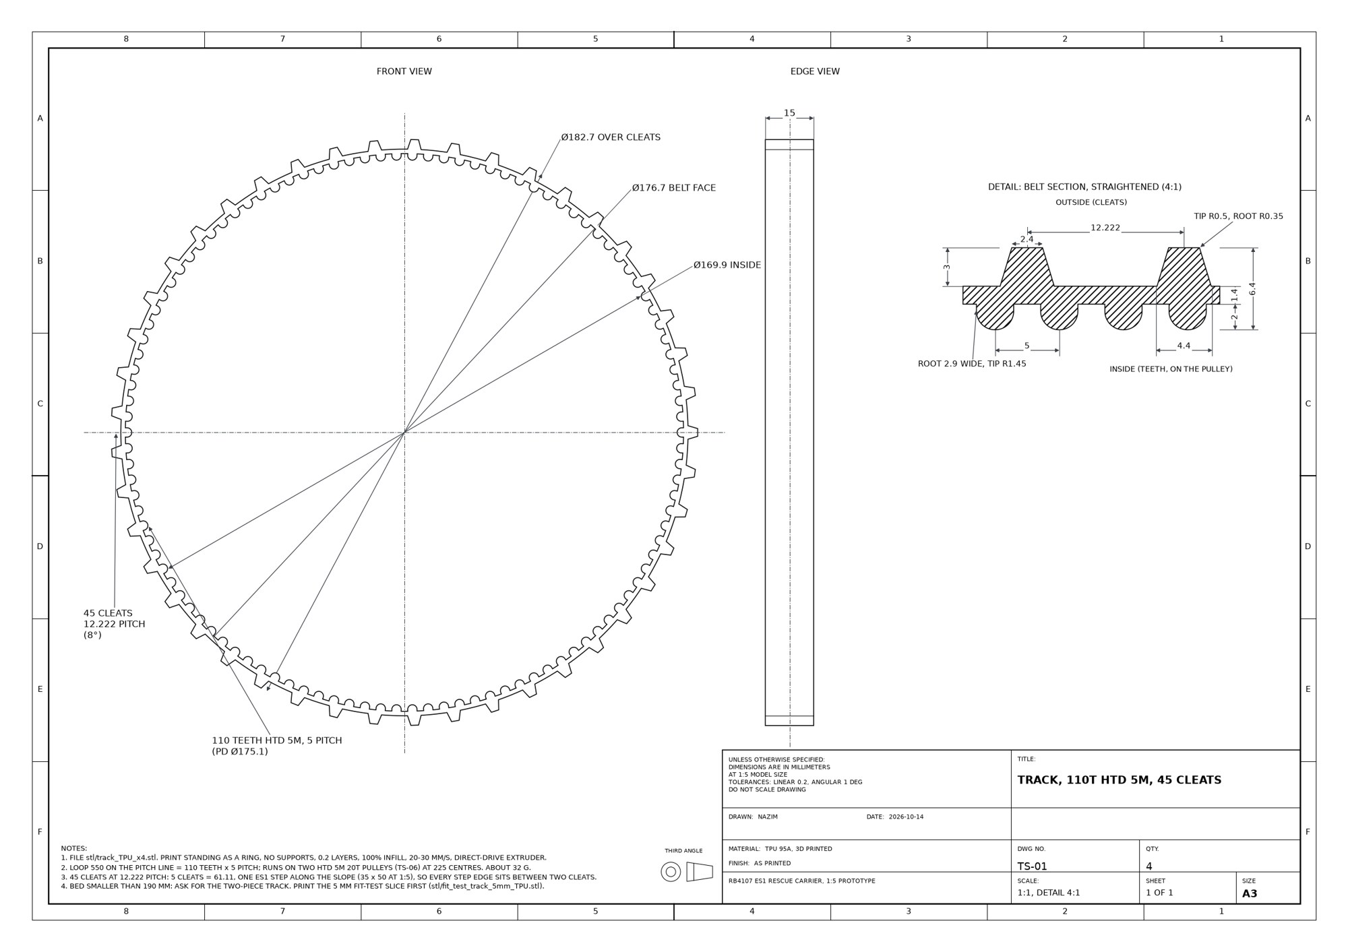
[picture p140: page 15]

## 5. WHAT THE RUNS SLIDE ON: RAILS AND CARRIER ANGLES

Between the two wheels of a segment the loop would sag and the teeth would climb under load, so each run slides on a UHMW rail, 186 x 20 x 5, one above and one below, on each plate. The rails sit 13.3 mm from the shaft axis, just under the tooth tips, which is why the tension check pulls a run away from the rail instead of pushing it.
Rev B held each rail with four small clips; the reviewer called the contact area too small. TS-10 replaces them with a full-length 10 x 10 x 1.5 aluminium angle per rail: one leg on the plate face, screwed with three M3 x 6 into new tapped holes at x 40, 105 and 170 (y ±3.5), Loctite 243, 1.0 N·m; the other leg under the upper rail or on top of the lower rail, with the rail screwed to it by three 3 x 5 thread-forming screws into blind pilots 4 deep, at 20, 93 and 166 from the rail's hinge end (x 38, 111, 184) and 7.5 from the plate face: the rail is only 5 mm thick and its far face is what the track slides on, so a longer screw would come out of it. The plate leg is cut down to 6.5 mm so the upper and lower angles do not meet on the plate's centreline. The rails are trimmed from 189 to 186 so the idler's flange clears them at x 223. Do not drill the old clip pilots in the rails: they overlap the new ones at x 38 / 40 and 184 / 185.


Fig. 11 A rail on its carrier angle on the plate face, from the interactive model.

## SHEET TS-10: RAIL CARRIER ANGLE


## 6. ORDER OF WORK FOR THE TRACK SIDE, AND WHAT TO HAVE ON THE BENCH

WHEN | STEP | TIME | GO / NO-GO CHECK
Before build day | Wheels back from the workshop: 4 hinge wheels and 2 stage-2 pulleys reamed 8 H7 with their Ø2.5 hub holes; 4 idler wheels bored 16 H7. Shaft cut to 82.3 and 77.3, ends chamfered. Tabs, sliders, carrier angles made; rails trimmed and drilled. Loops fit-checked on two wheels at 223 centres. | workshop 1 to 2 weeks; 4 h of own work | Shaft slides through every reamed bore with no shake and no stiff spot; a 688 enters the idler bore with a light press and does not fall out
Step 1 Press the 688s: into P1, P2 and P17 (Loctite 641 on the outer ring), and
| two into each idler wheel with the sleeve between | 30 min, then cure | An idler on its bearings spins free with no rock

Steps 3

and 5 | Rails on their carrier angles, angles onto the plates | 30 min each | Angle lies flat with no rock; rail ends at 207
Step 6 | Hinge wheels and stage-2 pulley held in position with their shims | 20 min | The bare shaft enters each wheel from the bearing without lifting it
Step 7 | Shafts in, feeler gaps set, three pins per side (section 1.4) | 2 h both sides | Shaft turns free; axial play = feeler gap only; paper passes at every face
Step 10 Idlers on their shoulder screws through the slots, sliders, nuts finger-
| tight, tabs on (section 4.2, 1 to 3)

40 min for four Wheel spins free on the loose screw;
| | | jack screw meets the foot squarely
Step 11 Loops on, tensioned, locked (section 4.2, 4 to 9) | 30 min for four Deflection in range; one full turn by
| | | hand with no click; nut 7 N·m

Fasteners for these joints

JOINT | FASTENER | QTY PER MACHINE | TORQUE THREAD- LOCKER

Hinge wheels and stage-2 pulleys to the shafts

| ISO 8752 spring pins 2.5 x 24 (hinge wheels) and 2.5 x 16 (stage-2 pulleys, or an M4 cone-point set screw in a seat) | 4 + 2 | driven flush (set screw about 1 N·m) none (243 on a set screw)
Idlers | ISO 7379 Ø8 x 25 M6 shoulder screw; 8 x 11 x 1 head washer; 8 x 11 x 0.5 shim; sleeve 8 x 10 x 9; slider; M6 nyloc
4 sets | 7 N·m | none
Tensioner tabs | M3 x 6 SHCS into the plate; M4 x 20 jack screw | 4 + 4 | 1.0 N·m / by feel, backed off a quarter turn

243 on the M3

Rail carriers to plates | 3 x M3 x 6 SHCS per angle | 24 | 1.0 N·m | 243
Rails to carriers | 3 x 3 x 5 thread-forming per rail, blind pilots | 24 | seat the head, no more | none
Bearings in P1, P2, P17 688-2RS pressed, seat reamed 16 H7 | 6 | press | 641 on the outer
| | | | ring

Tools for these steps
Arbor press or a vice with soft jaws (bearings); cordless drill, long-series Ø2.5 HSS bits x2, cutting fluid, 2.5 pin punch, small hammer; feeler gauges 0.3 and 0.5; hex keys 2.5, 3 and 4; 10 mm spanner; torque screwdriver to 1 N·m and a torque wrench to 7 N·m if available (otherwise the feel described); digital calipers; steel rule; a bent-wire hook and a spring scale reading 4 N; two G-clamps; Loctite 641 and 243; marker; a strip of paper.

Sources: the manufacturing and assembly plan (sections 5.3 to 5.8, 7 steps 6, 7, 10, 11, and procedures 8.2 and 8.3), sheets TS-01, TS-06, TS-09, TS-10 and TS-11 with their explainer pages, and the shared 3D model. Decisions on set screws and the sector gear: plan Appendix C, items 12, 13, 16 and 17.
