Naz712/fleet_adapter_template/3d_models/changi_es1_rescue_stairs/slides/track-deck/track-3d-print-fit.png

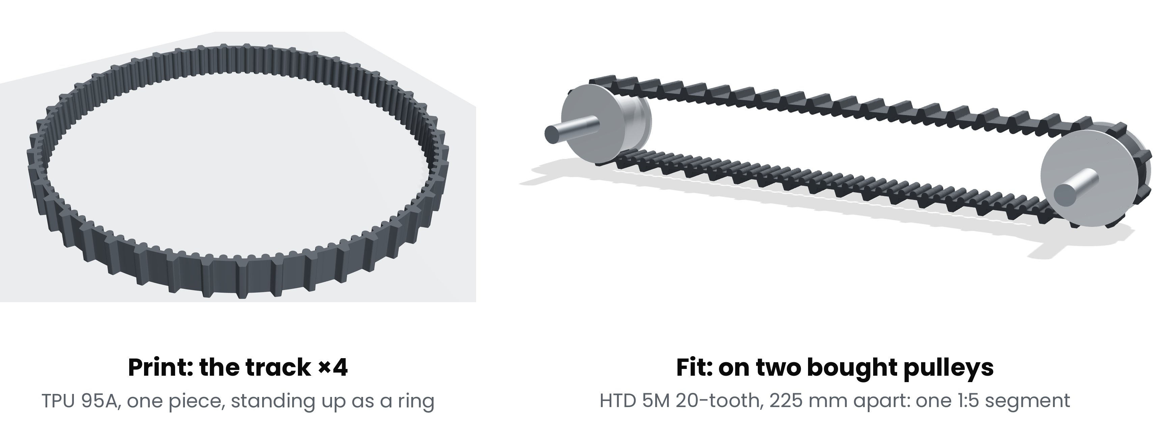
3d_models/changi_es1_rescue_stairs/slides/track-deck/track-3d-print-fit.png
