Naz712/fleet_adapter_template/3d_models/changi_es1_rescue_stairs/track_print/assembly/drawings/motion_and_drive.png

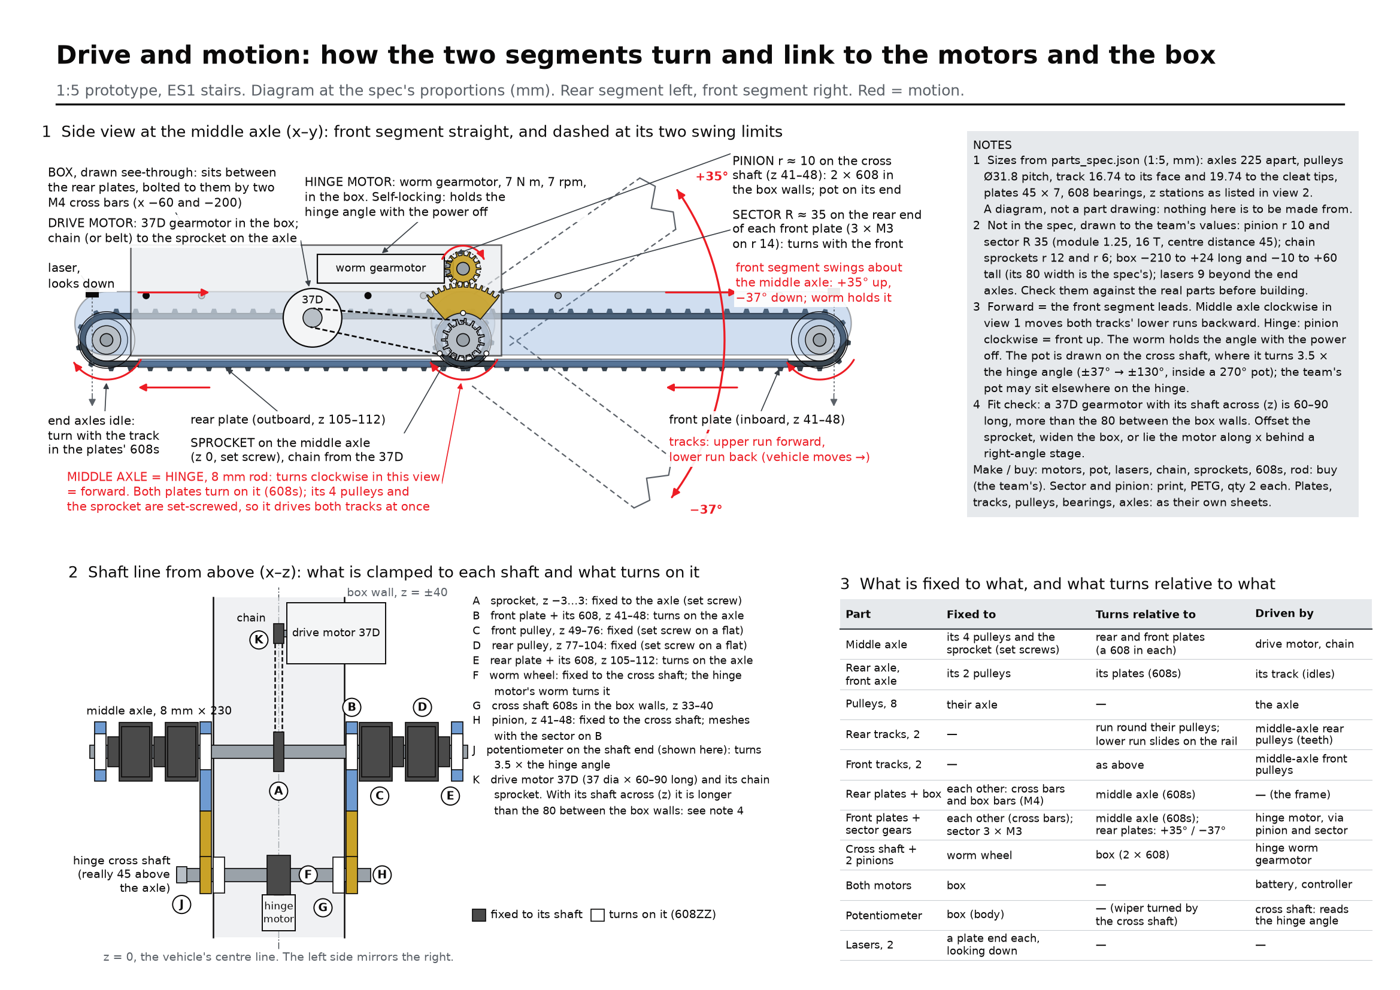
3d_models/changi_es1_rescue_stairs/track_print/assembly/drawings/motion_and_drive.png
