Naz712/fleet_adapter_template/3d_models/changi_es1_rescue_stairs/track_print/assembly/drawings/part_bearing_and_fasteners.png

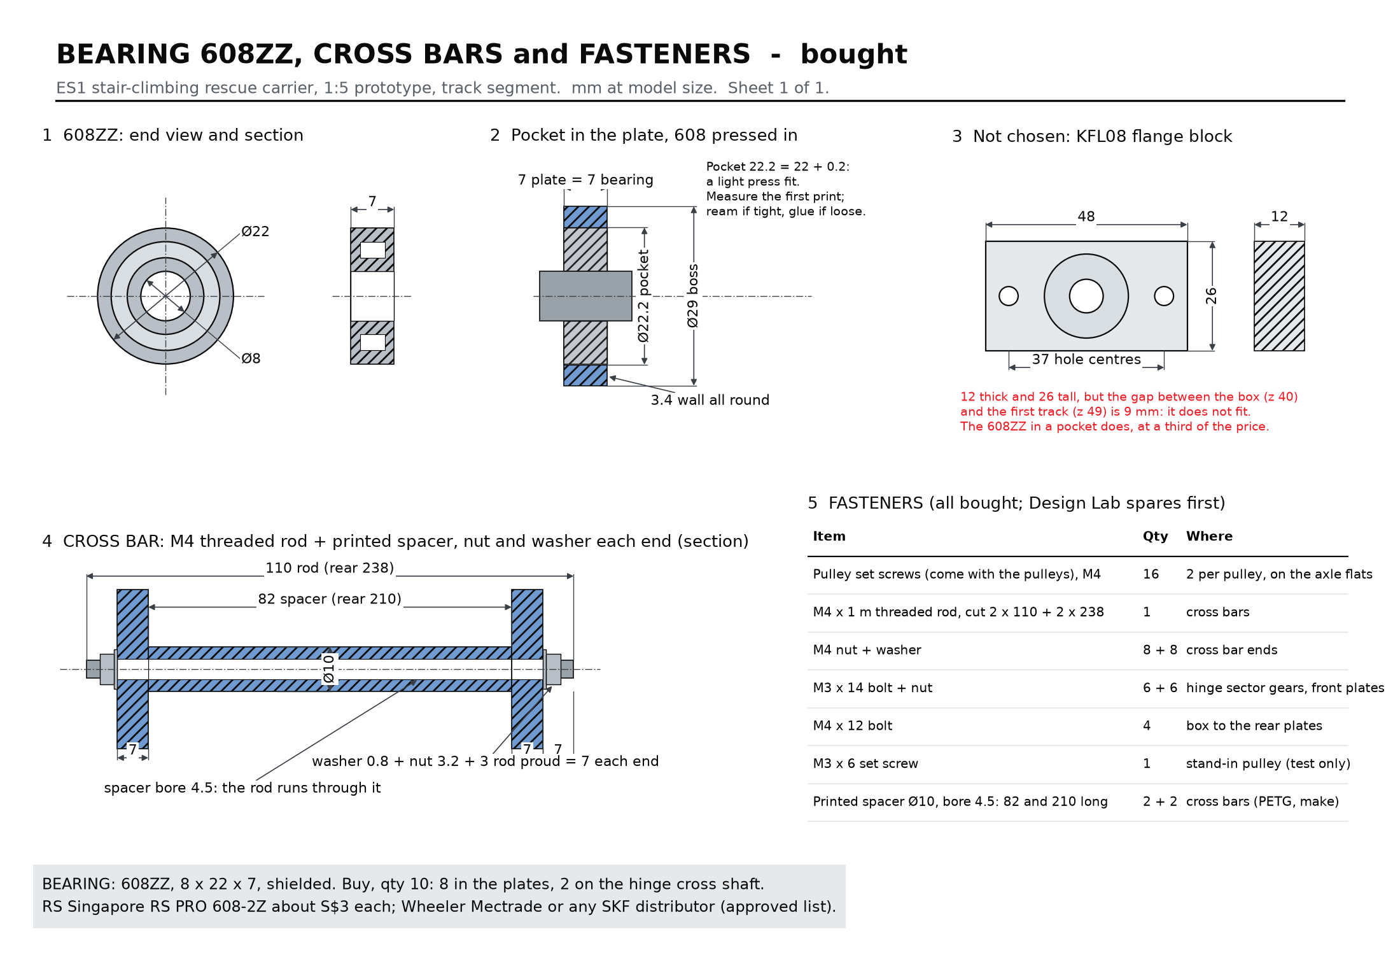
3d_models/changi_es1_rescue_stairs/track_print/assembly/drawings/part_bearing_and_fasteners.png
