Naz712/fleet_adapter_template/3d_models/changi_es1_rescue_stairs/track_print/assembly/drawings/TS-08_rear_segment_to_base.png

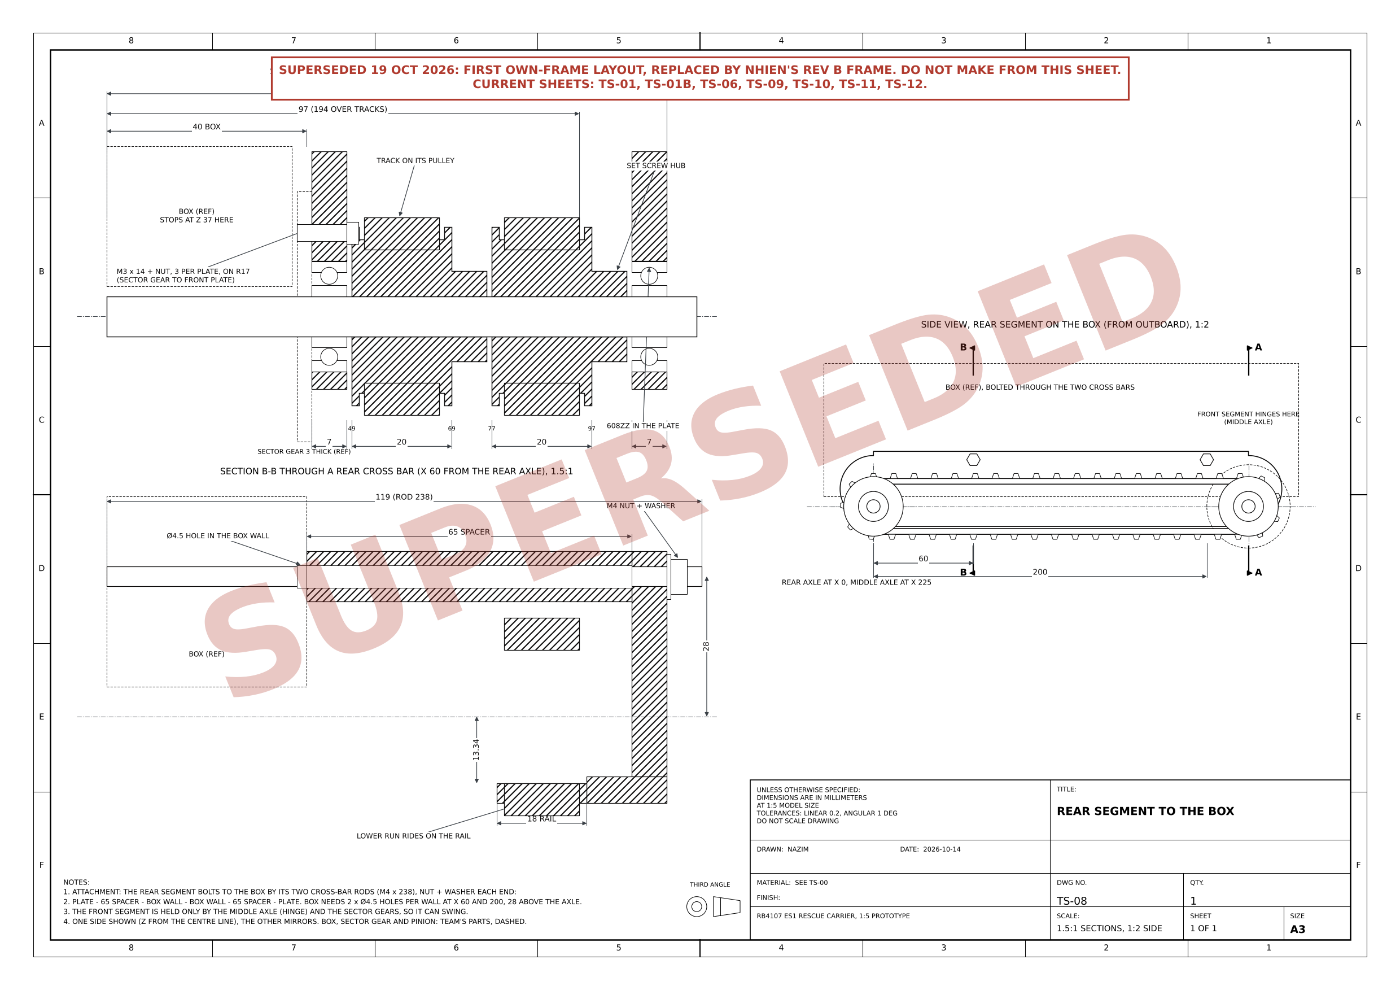
3d_models/changi_es1_rescue_stairs/track_print/assembly/drawings/TS-08_rear_segment_to_base.png
