Naz712/fleet_adapter_template/3d_models/changi_es1_rescue_stairs/track_print/assembly/track_detail/img/r_nose.jpg

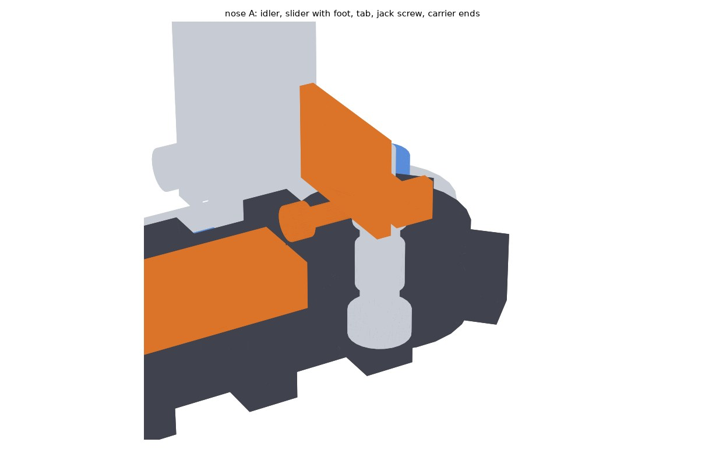
3d_models/changi_es1_rescue_stairs/track_print/assembly/track_detail/img/r_nose.jpg
