Naz712/fleet_adapter_template/(commit log)

2026-09-26 Add 3D-print model of the Changi AES ES1 rescue stairs
    Parametric generator (manifold3d) for the Rosenbauer E8000-type rescue
    staircase, without the vehicle, at the 3.2 m, 5.8 m and 8.4 m platform
    settings: 1500 mm wide, 170 mm steps, 18-tread bottom flight, 1000 mm mid
    platform and a 2800 x 3000 mm top platform. Includes 1:100 STLs with and
    without a display stand, colour-split STLs for multi-material printing,
    preview renders and printing notes.
    Claude-Session: https://claude.ai/code/session_014wM4fAmHBiJaRepdpStSox
    [ES1_stairs_3.2m_1-100.stl, ES1_stairs_3.2m_1-100_grey.stl, ES1_stairs_3.2m_1-100_lime.stl, ES1_stairs_3.2m_1-100_red.stl, ES1_stairs_3.2m_1-100_silver.stl, ES1_stairs_3.2m_1-100_stair_only.stl, ES1_stairs_3.2m_1-100_stair_only_grey.stl, ES1_stairs_3.2m_1-100_stair_only_lime.stl]
2026-09-28 Add two-track stair climber simulation for the ES1 stairs
    A quasi-static model of a tracked vehicle split into front and rear
    units with a driven hinge, crossing the ES1 rescue stairs at 3.2, 5.8
    and 8.4 m, compared against one long straight track. The page animates
    the trip, charts load tilt and hinge bend, and reruns the model when
    the vehicle design changes. README lists the resulting design rules.
    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
2026-09-28 Carry a casualty in a self-levelling reclining seat in the stair sim
    Replace the generic load box with a reclining stretcher-chair and a
    1.80 m, 120 kg person, on a driven pivot that keeps the seat level. The
    model checks the gap from the seat and person to the steps and to the
    vehicle's own tracks, and lags the levelling by its drive speed.
    The hinge now holds its fold over an edge until the centre of mass is
    5 cm past it, which removes the rock-back going up. The page adds
    person, recline and seat-height controls, a sitting-to-lying table and
    the drive, hinge and levelling loads for the chosen mass.
    Claude-Session: https://claude.ai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
2026-09-28 Say the stair sim results are the worst case over the three heights
    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
2026-09-28 Show how the seat post works in the stair sim
    Make the 0.5 m seat post the default, so every posture from sitting up
    to lying flat fits. The model now reports the bend the seat puts on the
    post and on the levelling drive, and how far the vehicle can tilt
    sideways before it tips.
    The page draws the averaging link that keeps the post halfway between
    the two track units, and adds side and front views with numbered parts
    and their loads. The README describes the same parts.
    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
2026-09-28 Stress test the stair climber and add a balancing seat arm
    Add a stress test (stress-test.js) that runs the vehicle through a
    heavier or lighter person, a person sliding along the seat, sitting
    up and lying flat, steeper stairs, slower motors and drive failures,
    at all three heights and in both directions. It measures how far the
    weight can lean anywhere before the vehicle falls, against the 7.3°
    of a hard stop, and sizes the seat support at twice the worst load.
    The test showed a fixed arm is weakest when the person slides towards
    their feet or the stairs are steeper. A drive at the foot of the arm
    now leans it to keep the weight away from the nearest edge, the seat's
    load centre sits 15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
2026-09-28 Compare four ways of holding up the seat in the stair sim
    Model two more seat supports: two arms rising in a V from the hinge,
    and two arms standing on the track units like a bed on two legs. Both
    carry a level cradle on a pin and a sliding pin, with a drive at each
    arm's foot that levels the cradle and moves it fore and aft to keep the
    weight away from the edges.
    The stress test now runs all four supports. The single balancing arm
    passes the most cases (16 of 23), the V arms 12 of 20, and arms on the
    tracks only 7 of 20, because the tracks swing at every fold and sit at
    different heights on the flights. The page gets a seat-support picker,
    drawings and a parts list for each support, and a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
2026-09-28 Model and stress test a stair climber with one half split in two
    The track model now handles a chain of track sections with the seat on
    the middle hinge: each section settles onto the stairs, the first one
    reaching over an edge folds down, the seat's hinge stays lifted until
    the weight is past the edge, and the hinges are rate limited with the
    seat's hinge leading. With two 0.70 m sections it gives exactly the
    same poses as the two-section solver.
    Contacts for the lean check are now taken per half of the vehicle, so
    a joint inside a straight run no longer counts as a track end.
    The stress test adds a front-split and a rear-split layout (0.70 m plus
    two 0.35 m sections, balancing arm) with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
2026-09-29 Let the split half of the stair climber bend while it trails
    The extra hinge of a split half now bends only while that half trails
    (going down for a split front half) and holds its sections in line
    while it leads. Trailing over a platform edge, the end section stays
    flat on the stairs while the section next to the seat follows the new
    slope, so the trailing end keeps holding the vehicle up when a straight
    unit would lift off. It turns at twice the seat hinge's rate (240
    deg/m by default), since its sections are half as long.
    With the balancing arm, worst over the three heights, the front split
    now takes 10.3 deg up and 18.7 deg down (two sections: 10.7 and 8.3)
    and passes 20 of 26 stress ca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
2026-09-29 Add a side-by-side comparison of the front split and two sections
    compare.html runs both stair climbers in step on the same stairs, with
    live lean, tilt and hinge readouts, plots the lean each can take along
    the trip, and lists every stress case for both with which one is
    better. compare-test.js writes the per-height numbers it shows
    (compare-results.js); the cases come from stress-results.js.
    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
2026-09-29 Call the plain vehicle "No split" on the comparison page
    "Two sections" read as the front half in two sections; the page now
    calls the vehicle with a single middle hinge "No split", as in the
    brief, and the title follows.
    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
2026-09-29 Compare four track layouts: no split, front, rear and both halves split
    Add the layout with both halves split into two 0.35 m sections to the
    stress test, the comparison run and the simulator's layout picker, and
    rebuild compare.html to run all four side by side. Both halves split
    takes 18.8° up and 18.4° down against 10.7° and 8.3° with no split, and
    passes 20 of 26 stress cases, like the front split. Going down it takes
    0.3° less than the front split, only because of the rear hinge motor's
    weight.
    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
2026-09-29 Let a leading split half keep contact with the stairs
    A split half that goes first used to be held straight. Now it stays in
    line but lets its end section down onto the next step about its own
    hinge once that hinge is past an edge (leadMode 'droop', the new
    default), so the tracks touch the stairs while the seat's hinge is still
    folding. Both halves split now takes 21.5° going down instead of 18.4°
    and passes 23 of 26 stress cases instead of 20; the front split takes
    11.2° going up instead of 10.3°.
    The comparison page gets a Next hinge bend button and a note on how the
    extra hinges bend; both pages describe the new behaviour.
    Cla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
2026-09-29 Show the split hinges bending in the simulators
    Each bending extra hinge gets a ring and a tag with its bend, playback
    slows to a quarter while one is bent, and the simulator opens on the
    layout with both halves split and gets a Next hinge bend button.
    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
2026-09-29 Add a 1:10 build blueprint for the both-halves-split layout
    blueprint.html draws the model to scale from the GT2 pulley and belt
    loop chosen (20T with 110 mm loops, both sold in Singapore, gives
    exactly 1:10): side view, top view, hinge joint, wiring and test stairs
    to match, plus a parts list with shop links (blueprint-parts.js). It
    runs the simulator on the test stairs and lists the servo angles every
    5 mm of travel. track-model.js gains lowerTreads and topPlatform options
    for stairs other than ES1.
    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
2026-10-01 Size a centre box for the battery and drive motor, and the tracks and tread
    The box is bolted to the section just behind the seat's hinge (T2), so it needs
    no extra linkage. Its space comes from every pose of the four-section chain in
    that section's frame: 500 x 300 x 250 mm full size (290 mm behind the hinge
    axle, 210 in front, floor 40 and top 290 above it), 50 x 38 x 25 mm at 1:10.
    Up to 40 kg in it slightly improves the lean margins.
    The blueprint gains a centre box sheet, a track and tread sheet, and a table of
    box and track sizes with how the drive works. The side and top views now show
    side plates inside the belts, stock pulleys with their hubs, and the box holding
    the drive motor, t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
2026-10-01 Compare no bending, 2-part and 4-part tracks with the platform on the box
    A new page runs the casualty up and down the ES1 stairs as measured (35 degrees,
    1 m mid-landing, 3 m top platform) on one stiff track, two units and four
    sections, in step, and marks the danger spots in plain words. It uses the
    team's levelling design: the platform hinged on top of the centre box and kept
    level by an actuator (new mastMode 'base'). Each pose now checks the box's gap
    to the steps and to the platform. The tracks follow HTD 14M timing belts on
    36-tooth pulleys with 15 mm cleats.
    With no bending the vehicle tips at the mid-landing and top edges; with 2 parts
    it keeps only 2.1 degrees at the top edge goin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
2026-10-01 Model the tracks on Singapore-stocked parts and test 2-part track lengths
    The bending test now models the tracks on parts MISUMI keeps in its Singapore
    warehouse: HTD 8M timing belts, 40 mm wide, on 60-tooth pulleys (1200 mm belts
    for 0.36 m sections, 2000 mm for 0.76 m units), and HTD 5M parts for the 1:5
    prototype. A new table lists them with MISUMI Singapore links.
    It also answers whether a shorter 2-part track would help: it does not. Halves
    of 0.6 m or less tip going down over the top edge, and the best length, about
    0.8 m, still keeps only 5.7 degrees there.
    Claude-Session: https://claude.ai/code/session_014wM4fAmHBiJaRepdpStSox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
2026-10-01 Stop, bend, then go: hinged tracks stop at each edge to bend, with a front laser
    The bending test now defaults to a stop-bend-go control. The vehicle stops
    wherever a hinge or the levelling must turn further than it can on the move,
    a hinge only turns as far as still leaves 25 degrees of lean (otherwise it
    holds its bend until more track is on the stairs), and a downward laser at
    the leading end keeps the hinges locked near an edge until it reads a set
    drop. The 2-part track becomes as safe as the 4-part one (25 degrees both
    ways) for 5 to 9 s of stops a trip; a 1 1/4 riser laser setting is best,
    2 or 3 risers is too late at the mid-landing.
    The page adds the control and laser setting, draw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
2026-10-01 Keep the bending tracks on the stairs: no hinge lifts the vehicle more than 5 cm
    The 4-part track arched over the mid-landing: its front half was held
    straight and the middle hinge lifted the vehicle up to 37 cm, standing it
    on its two ends. The 2-part's tent did the same, up to 39 cm. That needs a
    hinge motor that can hold the whole vehicle and casualty off the ground,
    with only the end tracks gripping.
    A new reach: 'lie' option makes every section lie on the stairs about its
    inner hinge, folding a track end down past an edge only if no hinge rises
    more than maxLift. The bending test uses it with 5 cm. Stopping to bend,
    the 4-part track keeps 24.4 degrees both ways, as before; the 2-part k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
2026-10-01 Add a front-arms layout after the Cal Poly Pomona stair climber
    The bending test gets a fourth layout modelled on the GrabCAD "Wheelchair
    Stair Climber": a stiff main track with track arms on its front axle that
    swing up to climb a step and down to reach over an edge. Scaled up, a
    0.80 m main track carries the box and platform at its middle and 0.72 m
    arms swing down up to 90 degrees or up 45 (the platform is in the way).
    A new reach: 'touch' mode rests the main track on the stairs by its own
    weight and swings the arm until it just touches the stairs ahead, so it
    catches the vehicle at an edge but never props it up; a dirs option runs
    one direction, since the arms lead both ways (it turns r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
2026-10-01 Stop the 4-part track humping over an edge
    With the tracks lying on the stairs, the 4-part chain's seat hinge followed
    the path of a pulley rolling round the edge, a few millimetres lower than a
    track folded over the edge sits. The sections either side then could not
    lie flat without their belts cutting the corner, so both tilted up about
    13 degrees and the vehicle humped, the end hinge 8 cm off the platform.
    The lying chain now puts the seat hinge on the pitch line moved up by the
    pulley radius with its corners kept sharp (at most 4.4 mm higher, within
    5 cm of a crest), so it folds cleanly over the edge. Its lean is unchanged
    (24.4 degrees both ways); the trip down takes a second longer. T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
2026-10-01 Bending test: 0.70 m units, build drawings, hinge explanation, priced parts
    Use 0.70 m 2-part units (stock 1880 mm HTD 8M belts) and replace the
    length sweep with a 0.69 / 0.70 / 0.76 m table. Drop the model notes.
    Add a top-view drawing and a side view of the hinge with labelled
    arrows, how the hinge works and when it bends, a main dimensions table
    and a parts list with rough Singapore prices. Update the README.
    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
2026-10-01 Add slide images: top view, hinge side view, stop-bend-go frames
    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
2026-10-01 Draw the 4-part version's top view next to the 2-part
    One top-view routine now draws either layout from its section lengths:
    the 4-part has three hinges, the end-hinge motors on the end sections.
    Add its parts and rough cost to the page and README, and its slide image.
    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
2026-10-01 Leave the platform levelling to its own design
    The levelling actuator only tilts the platform, which is designed
    separately, so drop it from the top views and drop the actuator, the
    platform pivot blocks and the IMU from the parts list. One motor driver
    now covers the drive and the hinge at full size. Totals: about S$370
    at 1:5 and S$4,700 at full size; the 4-part version about S$640 and
    S$8,500. Re-render the two top-view slide images.
    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
2026-10-01 List only the track and hinge parts
    The motors, battery, lasers and controller come from another team
    member, so the parts list keeps the belts, pulleys, axles, bearings,
    hinge gears (now with their cross shaft), tread and plates: about
    S$240 at 1:5 and S$3,000 at full size; the 4-part version about S$440
    and S$5,900. Add two small slide drawings for the parts that are made
    rather than bought: the hinge gears and the tread with cleats.
    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
2026-10-01 Hinge: either unit tips, brake on the worm, printable 1:5 gears
    Say that the bend is the angle between the units, so going down the
    rear unit (with the box) is the one that tips over the edge. A worm
    resists back-driving but can creep under vibration, so the hinge motor
    gets a spring-applied brake. At 1:5 the scaled gears would be too
    small to print and need over 400 degrees of servo travel, so use module
    1.25 gears at 32:14 teeth (about 2.3:1): a 270 degree servo then covers
    the whole +-55 degrees.
    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
2026-10-01 Size the full-size axles at 35 mm and add slide strips
    The worst case is a step edge under a unit's end while the belts pull
    hard, about 1.7 kN on a pulley. The rear unit's outer-lane belts sit
    108 mm outside its bearings (about 180 N m of bending), and the middle
    axle adds the chain pull and up to about 65 N m of torque per side.
    35 mm C45 bar in UCFL207 units holds that with a safety factor of about
    3 and keeps the outer pulleys tilted under 0.25 degrees; 30 mm would
    tilt them 0.34 degrees. Add a low-friction slide strip under each belt
    so the tracks stay straight between the pulleys. Totals: about S$240
    at 1:5 and S$2,900 at full size.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
2026-10-09 Add printable 1:5 track matched to the ES1 steps
    A one-piece TPU track printed as a ring, with one- and two-lane PETG
    sprockets for the 8 mm axles. The cleats are 12.21 mm apart, a fifth of
    the 1:5 ES1 nosing-to-nosing distance, so every nosing under a unit sits
    between cleats; 31 cleats on 8-tooth sprockets put the axles 140.4 mm
    apart. Includes a fit-test slice, a 1:5 step gauge, the generator with
    its seating and mesh checks, previews and build notes.
    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
2026-10-11 Add slide graphics for the track and hinge slides
    The four track options, simulation stills, the track on the 1:5 ES1
    steps and the printed parts, for the milestone deck. The side view can
    now be drawn without its heading.
    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
2026-10-11 Print the track for the team's 1:5 base on bought HTD 5M pulleys
    The team's base has 225 mm segments with 550 mm track loops on wheels about
    1.5 cm in radius. The printed TPU track now has 110 HTD 5M teeth inside, so
    it runs on stock 20-tooth pulleys at exactly 225 mm, and 45 cleats outside,
    still five per 1:5 ES1 step. The printed sprockets are dropped. In the
    simulator 1.125 m segments keep 14.5 deg down and 18 deg up. Adds slide
    graphics: the two options at the team's lengths, simulator stills and the
    stop-bend-go strip at 1.125 m, the laser wiring and the print/buy parts.
    Claude-Session: https://claude.ai/code/session_014wM4fAmHBiJ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
2026-10-11 Add the hinge side view at the team's 1.125 m segments for the slides
    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
2026-10-11 Add top view, dimensions and 3D track renders at the team's 22.5 cm segments
    The top view and dimensions table now use the team's base: 2 x 225 mm segments
    at 1:5 (1125 mm full size), 550 mm track loops, 15.9 mm wheel radius. The lanes
    are sized for the bought HTD 5M pulleys (20 mm over the flanges, hubs outboard),
    so the base is 180 mm wide over the tracks at 1:5. The 3D renders wrap the
    printed track STL onto its loop: as printed, on two pulleys, and the whole base
    going over the top edge of the ES1 stairs with the hinge bent 35 degrees.
    The track README names MISUMI Singapore from the approved vendor list.
    Claude-Session: https://cl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
2026-10-11 Widen the top view and dimensions to clear the pulley hubs
    The bought pulleys' hubs face outboard, so the outer lane sits outside the inner
    pulley's hub: 900 mm over the tracks at full size, 180 mm at 1:5. Also moves the
    rear track label off the rear axle.
    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
2026-10-13 Add a printable stand-in pulley to test the track's teeth
    A PLA copy of the bought HTD 5M 20-tooth pulley (0.15 mm groove clearance,
    8 mm bore, M3 set screw in the hub) so the printed track can be fit-tested
    before the bought pulleys arrive. Test only. Adds a picture of the four
    parts to print. The track, test slice and step gauge files are unchanged.
    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
2026-10-13 Add the track segment parts spec and drawing helpers
    parts_spec.json is the source of truth for the assembly drawings: every
    part of one 1:5 track segment with its dimensions, count and make-or-buy.
    It settles the layout: front plates inboard, rear plates outboard (186 mm
    over the tracks), 608ZZ bearings pressed into printed PETG plates instead
    of KFL08 blocks, axles 220/220/160 mm, and printed slide rails on the
    plates. drawing.py holds the shared dimension-line helpers.
    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
2026-10-13 Add the printed frame parts and the buy-vs-make table for a track segment
    generate_frame.py builds the four side plates (integral slide rail, 608ZZ
    pockets, cross-bar and sector-gear holes) and the cross-bar spacers from
    parts_spec.json and exports them print-oriented. buy_vs_make.md lists every
    part with where to get it from the approved vendor list and the prices
    found so far.
    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
2026-10-13 Add the track, pulley and drive-and-motion drawing sheets
    Dimensioned sheets drawn from parts_spec.json: the track's ring and belt
    section, the HTD 5M 20T pulley with its order spec, and a diagram of what
    turns on which shaft and how the segments link to the drive motor, the
    hinge motor and the box. The frame preview is refreshed.
    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
2026-10-13 Tidy the section marks on the track sheet
    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
2026-10-13 Assembly drawing set for one track segment, spec v2
    Sheets drawn from assembly/parts_spec.json: exploded segment with every
    screw depth, side plate with slide rail, axles, bearing and fasteners,
    plus the track, pulley and drive-and-motion sheets updated to v2.
    Spec v2 fixes what the frame check found: 20 mm lanes (the pulley over
    its flanges), R14.5 bosses round the bearing pockets (3.4 mm wall), plates
    45 tall with cross bars at 28 so the rear spacer clears the cleat tips,
    sector bolts on R17, axles 230/230/160, rear spacer 210. The plate and
    spacer print files are regenerated to match.
    Claude-Session: https://claude.ai/code/session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
2026-10-14 Add CAD-style A3 engineering sheets for the track segment parts
    TS-00 assembly (top, side, end views, balloons, parts list) and one
    sheet per part: track, front and rear side plates with sections, axles,
    spacers, bought pulley and bearing. Monochrome, true scale, third angle,
    title block; all numbers from parts_spec.json. README lists them.
    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
2026-10-14 Add procurement list for the track segment parts
    Make or buy per part, vendor links from the approved list, Singapore
    prices seen on 14 Oct 2026, quantities from parts_spec v2 and stated
    delivery times, with the order of events.
    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
2026-10-14 Expand the procurement list into a piece-by-piece parts and build guide
    Printer fit on the Fab Lab UP300/UP600 (no split needed), make-where
    table with request-form justifications, per-segment piece counts,
    totals, assembly order and the buy list with links.
    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
2026-10-14 Add TS-08 rear segment to box sheet; rear spacers become 2 x 65 per rod
    The box sits between the rear plates, so each rear cross-bar rod now
    carries two 65 mm spacers with the box clamped between them, and the
    rods themselves attach the segment to the box (no separate box bolts).
    Spec, print files, TS-00/TS-05 sheets, README and procurement updated.
    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
2026-10-14 Add the compiled track segment package PDF (sheets TS-00 to TS-08 and parts list)
    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
2026-10-15 Add STEP export of every track part and a placed two-segment assembly
    export_step.py builds B-rep solids from parts_spec.json with CadQuery and
    writes one STEP per part plus track_segments_assembly.step (53 named
    components) for SolidWorks. Shipped zipped in step/track_cad_step.zip.
    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
2026-10-15 Add shaded 3D how-it-works renders of the track assembly
    Rendered from the STEP assembly with three.js (headless): assembled on
    the flat with labels, bent 35 degrees down on the ES1 stairs, and with
    the plates pulled out; plus side and top views.
    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
2026-10-15 Add the printed parts pack: exploded renders plus the track, plate and spacer sheets
    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
2026-10-15 Add the layout with Nhien's Rev B side plates: z stations, axle and spacer consequences
    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
2026-10-15 Add the hybrid parts catalogue and procurement list for Nhien's Rev B plates
    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
2026-10-15 Add the complete track pack PDF (hybrid plan plus all-printed fallback)
    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
2026-10-15 Insert the connection map into the complete pack
    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
2026-10-15 Add the interactive 3D assembly viewer (explode, hinge bend, build steps, part info)
    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
2026-10-15 Viewer v2: assemble slider, joint-by-joint build, stairs; pack rebuilt from the same model
    Viewer: Assemble slider moves every part from its exploded place into the
    frame in Rev B's build order, with the joint and fasteners named; hinge
    slider, ES1 stairs toggle, drive train and electronics shown solid.
    Pack: new how-it-works and piece-it-together pages rendered from the
    viewer, cover with the link, TS-06 reissued as plain bore.
    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
2026-10-15 Viewer v3: hierarchical 11-step build with the printed track; pack front pages rebuilt
    Viewer: parts are grouped under the part they are fixed to and each step
    moves in from the side it is really fitted from, so nothing passes through
    anything else while the Assemble slider moves. Rev B's stock belts are
    replaced by the printed track on the same wheel centres. Drive pulley and
    motors are numbered (16, 17) with a drive-train-only view; the panel flags
    the Rev B deck clearance over the stock belt cleats.
    Pack: cover, how-it-works and piece-it-together pages regenerated from the
    new viewer stills with the 11-step captions.
    Claude-Session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
2026-10-16 Viewer v4: hinge stops from the Rev B geometry; pack Part B is now Nhien's own sheets
    Viewer: the whole front frame swings (both 2020 bars, sector gear P11 and
    its angle P14, P19 brackets, rails and hardware, nose idlers). The hinge
    slider stops where parts touch, from a part-against-part sweep at 0.1°:
    nose-up at 0° on the foam up-stops B18 under the deck, nose-down at 18.8°
    where the P14 corner meets the end of deck slot H; a checkbox shows the
    swing with the slot 3 mm longer. Pads and the hinge pinion classified.
    Pack: the all-printed fallback (my side plates) is out; Part B carries
    Nhien's Rev B sheets for the parts the track runs on and his BOM. Page 1
    adds the hinge-stop section dra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
2026-10-16 Bought-belt track option: drawing TS-01B with explainer, and its procurement list
    First half of the two-version pack (printed track / bought belt): the
    belt sheet drawn from Rev B's B10 spec (HTD 550-5M-15, 22 bonded cleats)
    with the deck-notch note, its explainer page, and the belt procurement
    list. The two complete packs and the viewer's track switch follow.
    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
2026-10-16 Two pack versions, printed track and bought belt, from one viewer model with a track switch
    Viewer v5: both track options in the data (var = mine / theirs), a Track
    menu that swaps them, belt texts from Rev B's B10, and #hl-<group> renders
    that fade everything but one group. The parts catalogues are now rendered
    from the viewer, so every page of both packs comes from the same model.
    Packs: RB4107_track_complete_pack_printed_track.pdf and
    RB4107_track_complete_pack_bought_belt.pdf replace the single pack; each
    carries its own catalogue, procurement list, track drawing (TS-01 or
    TS-01B) and deck note. Procurement lists renamed to match.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
2026-10-16 One complete pack with both track options instead of two files
    Shared pages once (build, catalogue with both track pages, merged
    procurement list with sections 1A / 1B, layout, connection map, wheel
    drawing), then an Option A section (printed track: option page, TS-01,
    explainer) and an Option B section (bought belt: option page, TS-01B,
    explainer), then Nhien's sheets. The per-version packs, catalogues and
    lists are removed.
    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
2026-10-16 Feasibility check and design-review fixes: pins, tensioner, rail carriers, stack-ups
    Pack: new feasibility page (22 items measured on the shared model with
    verdicts and fixes) and a build-day sequence with go / no-go checks.
    Drawings: TS-06 now reamed Ø8 H7 with a cross pin instead of a D-bore
    and E-clips; TS-09 idler tensioner (tab, slider, M4 jack screw); TS-10
    full-length rail carrier angle; TS-11 stack-ups along the hinge shaft
    and idler screw with the fits table. Explainers for all four.
    Procurement: round shaft, spring pins, tensioner and carrier parts,
    reamed bearing seats, cast corner brackets. Viewer texts updated.
    Claude-Se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
2026-10-16 Apply the design review to the model everywhere; zoom tools; drive, hinge and power check
    Viewer v7: plain round hinge shafts, E-clips removed, cross pins, idler
    tensioners (18), rail carrier angles (19), rails trimmed to 186, nuts
    moved for the sliders. Zoom menu for the hinge, idlers, sector, drive and
    deck; double-click or "Zoom to this part" flies to a part; closer
    minimum distance. Catalogue, connection map, layout note, parts spec,
    step captions and Part B divider now describe the reviewed fixings.
    Pack: a drive, hinge and power page (Pololu 2828 figures, 5840-31ZY
    variants, fuse and battery) and three more feasibility rows. 57 pages.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
2026-10-18 Buildability review: sector travel margin, hub pre-drill for the cross pins
    - Feasibility page of the pack: two rows added (hinge sector travel 35 to 37
    deg against the 35 deg stair pitch, ask Nhien for two more teeth; cross pins
    cannot be drilled on the press once the shaft is in, so the hubs are drilled
    first and the shaft through them in place), layout tightened to fit.
    - TS-06, EX-06, build-day page, viewer texts, procurement and README say the
    same; TS-06 notes wrapped clear of the title block.
    - Procurement: one spare pulley and 100 mm of shaft to practise boring and
    pinning on.
    Claude-Session: https://claude.ai/code/s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
2026-10-18 Tension check: pull the lower run off its rail with 4 N, not a push
    The rails sit right under both runs, so pressing a run inward cannot
    deflect it. TS-09, EX-09, the viewer texts and the pack's build-day and
    step-11 captions now say: machine on blocks, hook a cleat of the lower run
    at mid-span, pull it off its rail with 4 N, wind the jack screw until it
    gives 2 to 3 mm (belt 1.5 to 2.5), tighten the nut, back off a quarter
    turn. TS-09 notes re-wrapped and the plan view lifted clear of them.
    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
2026-10-18 CAD copy of the track unit with the review changes (STEP for Fusion)
    Built from Nhien's Rev B assembly STEP: track-unit parts only, plain round
    pinned shafts, rounded pulley bores with cross holes, spring pins, shims,
    trimmed rails, rail carrier angles, tensioner tabs and sliders with a foot,
    jack screws, plate holes for both; E-clips, grub screws, M6 washers and rail
    clips removed. 154 parts, interference-checked. Scripts and README alongside.
    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
2026-10-18 TS-09 and TS-10 corrected to the geometry the CAD copy carries
    Tensioner: tab 30 long, leg B 1.5 mm off the slot end so the nut's corners
    clear it, ear 7.5 x 8 with its M3 hole at (+-223, +11); the slider is an
    8 mm slice of the same angle with an 8 mm foot that the jack screw pushes
    (the flat slider sat 1 mm below the jack's axis, so nothing was pushed).
    Rail carriers: plate leg 6.5 so the upper and lower angles do not meet,
    six new M3 holes per plate at x 40, 105, 170 and y +-3.5 instead of the
    centreline clip holes. Sheets, explainers, viewer texts, procurement,
    README and the pack updated.
    Claude-Session: https://claude.ai/code/se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
2026-10-18 Record the pulley fixing decision and the bought sector gear option
    Hinge wheels stay cross-pinned (no hub in the 20 mm lane); the stage-2 pulley may
    keep a cone-point set screw in a spot-drilled seat with thread-locker. Propose a
    KHK SSAY1-100 cut to a 23-tooth sector for P11, with the centre distance change
    or a 22-tooth pinion for Nhien to choose. Procurement rows and README notes.
    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
2026-10-18 Group and name the track STEP as a part tree for Fusion
    Same 154 parts and geometry, re-exported as ten groups that follow the build
    order, with clear part names; relabel script and the tree listing added.
    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
2026-10-18 Handover notes and the focused track assembly document
    HANDOVER.md: where everything is, the decisions and where they are recorded,
    open items with Nhien, next steps and the numbers held. The 18-page track
    assembly document (shaft and pulleys, idlers, tensioner, loop, rails, order
    of work) with its builder.
    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
2026-10-18 Fusion brief for the track unit: what changed, why, and the drawing to make
    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
2026-10-18 Rail screws 3 x 5 into blind pilots, not 3 x 10; list the 52 screws missing from the STEP
    The rail is 5 mm thick and its far face is the track's sliding face, so the
    3 x 10 thread-forming screws first specified would have come 3.5 mm out of it.
    Corrected on TS-10, EX-10, the viewer text, the track document, the pack and
    the plan; the 24 carrier M3 x 6, 4 tab M3 x 6 and 24 rail screws are now in
    the Fusion brief and the procurement list.
    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
2026-10-19 Track unit: rail screw positions, 3 x 5 note, stage-2 pin 2.5 x 16
    TS-10: rail-leg holes at 20/93/166 from the rail's hinge end, 7.5 from
    the plate face; 3 x 5 thread-forming (not 3 x 10); old clip pilots not
    to be drilled. TS-11 and procurement 1C: stage-2 pulley pin 2.5 x 16.
    Brief and README updated to match.
    Claude-Session: https://claude.ai/code/session_01JCvVuLKCfivs9KhK1rRmqH
2026-10-19 Track unit: bring pages, PDFs and handover up to date (19 Oct)
    Stage-2 pin 2.5 x 16 and rail screws at 20/93/166, 7.5 from the plate
    face, now also in the detail page, explainer sheets EX-10/EX-11 and the
    viewer. Regenerated the detail PDF and procurement PDF; the complete
    pack carries the current TS/EX sheets and procurement pages; catalogue
    rail page stamped with the pilot correction. cad/README notes the STEP
    is behind the Fusion model; HANDOVER next steps updated.
    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
2026-10-19 Procurement 1C: hinge wheels bought bored 8, idlers bored 16 at the workshop
    MISUMI economy HTD 5M (H5M, not S5M): 20T offers finished bores up to
    about 15, so the four hinge wheels come bored 8 (type H, else P) and
    only the idlers go to the workshop. Check width over flanges and no hub
    before ordering. HANDOVER: old rail-clip holes in the plates unused.
    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
2026-10-19 Procurement: order of events for 19 Oct; rail clips not to be ordered
    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
2026-10-19 Track unit: TS-12 shafts and rails, old sheets marked superseded, stage-2 pin 2.5 x 12
    TS-12 draws hinge shafts A and B and the rail trim and blind pilots.
    TS-00, 02-05, 07, 08 (first own-frame layout) are stamped SUPERSEDED.
    Stage-2 pin is 2.5 x 12: the pulley's tooth roots are about 13.4, so a
    16 pin would reach into the belt grooves. New current-drawings PDF and
    START_HERE.md index; pack, procurement and detail PDFs regenerated.
    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
2026-10-19 Record Nhien's 19 Oct answers: 5 mm cleats, pinned stage-2, KHK at 60.1-60.2
    Option B belts with cleats cut to 5 mm (no deck notch), bonded by the
    belt maker; TS-01B redrawn. No DXF re-issue: M3 holes drilled on site.
    Set screws dropped. HANDOVER lists what is still open (seats and slots,
    old rail pilots, BOM screws, who orders). Pack and procurement PDFs
    regenerated.
    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
2026-10-19 Stage-2 pulley: MISUMI with hub and two set screws in seats, no cross pin
    Drilling a pin through the small toothed pulley was judged too fiddly.
    The stage-2 pulley becomes a MISUMI HTD 5M (9 mm belt) with hub, bore 8,
    two cone-point set screws in 1 mm seats, Loctite 243; the hinge shafts
    grow by the hub length (to confirm, so not cut yet). Hinge wheels keep
    their 2.5 x 24 pins. TS-06 updated for bought-bored wheels. Guide,
    procurement, pack and drawings PDFs regenerated.
    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
2026-10-21 Make the bought belt (option B) the main track in the guide and index
    Guide: TS-01B replaces TS-01; fit-check, deck clearance and re-tension
    text follow the belt with 5 mm cleats; the printed TPU loop is the
    fallback. Current-drawings PDF leads with TS-01B, TS-01 last.
    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
2026-10-21 Guide: shorten the track row so page 1 does not spill
    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
2026-10-21 Bought belts are the track everywhere: procurement order, README, old docs
    Procurement lists the bought belts first (1A) and the printed track as
    the fallback (1B). README carries the decision at the top; procurement.md
    and buy_vs_make.md (own-frame layout) are marked superseded.
    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
